Sopa-IA/Control-deck/assets/renders/prototipo/LEEME.md

# Renders del prototipo con las piezas de Miguel (diseño v3)

**Son renders del diseño CAD, no fotos ni un prototipo fabricado.** Generados con
`hardware/render/render_fotorrealista.sh` (Blender + Cycles).

Configuración: `pantalla="msi_15_6"` (MSI PRO MP161 E2U), `hp_preset="iris_mitx_desnuda"` (placa HP 260-a110ns,
17 × 17 cm, 35 mm), `usar_hdd_35=true` (HDD Toshiba 3,5"),
`usar_adaptador_video=false`, Raspberry Pi 4, Arduino Micro, 2 potenciómetros + 2 botones y tira LED ámbar.

**2026-10-20.** Estas imágenes no se han rehecho. Siguen mostrando un Arduino Micro. El CAD vigente es un Nano, con ESP8266, un segundo Nano y un panel en la trasera. La Pi 4, que aquí figuraba sin confirmar, la confirmó Miguel ese día; el HAT VHF no está en estos renders.

| Archivo | Vista |
|---|---|
| 01_frontal_3-4.png | Frontal 3/4 con la interfaz Orbit en la pantalla |
| 02_perfil_lateral.png | Perfil lateral izquierdo |
| 03_trasera_3-4.png | Trasera 3/4: I/O del HP y pasacables |
| 04_explosionado.png | Explosionada |
| 05_interior_cenital.png | Interior desde arriba con etiquetas |
| 06_lo-que-tienes-vs-donde-va.png | Cada pieza y su sitio (versión sin fotos personales) |
| 06_lo-que-tienes-vs-donde-va_con-fotos.png | La misma lámina con recortes de las fotos reales de Miguel (publicación autorizada) |
| 07_detalle_mandos.png | Detalle de la consola y de la textura de capas del PLA+ negro mate |

Exactitud de cada modelo: ver `hardware/render/CREDITOS-MODELOS.md`.
