Sopa-IA/Control-deck/docs/instalacion-hp.md

# Instalar hp-agent en el HP

Un paso por línea. El HP es Windows 10, sin Python. El cable interno une el HP (`<IP-del-HP>`) y la Pi (`<IP-de-la-Pi>`), cada uno con su IP fija. Ese cable no lleva internet: para bajar Python y el agente hace falta el Wi-Fi u otra red.

Por defecto la tarea arranca en vivo: `pythonw.exe -m hp_agent --live`, y el toml queda en `live = true`. Orbit muestra la telemetría, y Bloquear, Reiniciar y Apagar (60 s) se ejecutan ya. `-DryRun` deja solo la telemetría, por si algún día se quiere mirar sin tocar el equipo. Apagar y reiniciar, en vivo, esperan 60 s y se pueden anular.

El token no se escribe en pantalla ni en el registro. ssh pide la contraseña de la Pi y la escribe Miguel.

## Una línea

1. En el HP, abre PowerShell como administrador: clic derecho, Ejecutar como administrador.
2. Pega esta línea y pulsa Enter.

```powershell
[Net.ServicePointManager]::SecurityProtocol = [Net.SecurityProtocolType]::Tls12; $u='https://raw.githubusercontent.com/Sopa-IA/Control-deck/main/scripts/instalar-hp.ps1'; $p=Join-Path $env:TEMP 'instalar-hp.ps1'; Invoke-WebRequest -UseBasicParsing -Uri $u -OutFile $p; powershell -NoProfile -ExecutionPolicy Bypass -File $p
```

3. Cuando ssh pregunte la contraseña, escribe la de la Pi (usuario `orbit`, equipo `<IP-de-la-Pi>`). No se muestra el token.
4. Al terminar, en Orbit OS, Sistemas, la tarjeta del HP tiene que decir **Conectado**. La CPU, la memoria, el disco, el tiempo activo y la red se rellenan. La red va en kb/s, igual que la de la Pi: bajada y subida. La temperatura es la de la CPU si LibreHardwareMonitor está en marcha. Si no hay dato, esa fila sigue en raya y lo demás no se cae.
5. Bloquear, Reiniciar, Anular apagado y Apagar están en la tarjeta del HP y en el menú de apagado. En vivo se ejecutan. Apagar y Reiniciar esperan 60 s y piden confirmación. Anular cancela esos 60 s. Reproducir o pausar está en Herramientas y pulsa la tecla de medios de Windows.

La línea se puede repetir. Sin `-DryRun` deja otra vez el modo real. No cambia el token de la Pi.

## Qué hace

6. Si no hay Python 3.12, lo instala con winget (`Python.Python.3.12`). Si winget no está o no lo deja, baja el instalador oficial `python-3.12.10-amd64.exe` y lo ejecuta en silencio.
7. Baja el zip de la rama `main` a `C:\Orbit\Control-deck`. No hace falta git.
8. Crea `C:\Orbit\Control-deck\.venv` e instala `software/shared/python`, `software/hp-agent`, `pycaw` y `comtypes`. pycaw es el volumen de la salida por defecto. No cambia el token ni la tarea.
9. Por ssh, como `orbit@<IP-de-la-Pi>`, lee `ORBIT_HP_TOKEN` del `.env` de la raíz del clon. En la Pi ese archivo es `/home/orbit/Control-deck/.env`: lo escribe `scripts/gen-token.sh` y `scripts/instalar-pi.sh` no lo regenera si ya existe. `/etc/orbit/orbitd.env` tiene una copia, pero es de root y el usuario `orbit` no la lee.
10. Escribe `%APPDATA%\orbit\hp-agent.toml` con `hub_url = "ws://<IP-de-la-Pi>:8765/ws"` y `live = true`. Con `-DryRun`, `live = false`. El archivo no se enseña.
11. Crea la tarea oculta `OrbitHpAgent`. Arranca al iniciar sesión, con `pythonw.exe -m hp_agent --live`, sin ventana. Con `-DryRun` los argumentos son `-m hp_agent`, sin `--live`. Si el proceso se cae, el Programador de tareas lo relanza al minuto, hasta 999 veces, y no tiene límite de horas. La arranca ya.
12. Baja LibreHardwareMonitor 0.9.6 desde el release oficial de GitHub (`LibreHardwareMonitor.zip`, .NET Framework 4.7.2, licencia MPL-2.0). Comprueba el SHA256 `086d9f1b5a99e643edc2cfaaac16051685b551e4c5ac0b32a57c58c0e529c001` antes de copiarlo a `C:\Orbit\LibreHardwareMonitor`. Si el hash no coincide, no lo instala y el agente sigue. Enciende su servidor web solo en `127.0.0.1:8085`, minimizado a la bandeja, sin ventana. La tarea oculta `OrbitLibreHardwareMonitor` arranca al iniciar sesión con permisos de administrador. hp-agent lee ahí la temperatura de la CPU. Si no hay dato, prueba WMI `root/LibreHardwareMonitor` y, al final, `MSAcpi_ThermalZoneTemperature`.

## Solo mirar

13. La misma línea del paso 2, y al final `-DryRun`:

```powershell
[Net.ServicePointManager]::SecurityProtocol = [Net.SecurityProtocolType]::Tls12; $u='https://raw.githubusercontent.com/Sopa-IA/Control-deck/main/scripts/instalar-hp.ps1'; $p=Join-Path $env:TEMP 'instalar-hp.ps1'; Invoke-WebRequest -UseBasicParsing -Uri $u -OutFile $p; powershell -NoProfile -ExecutionPolicy Bypass -File $p -DryRun
```

14. En vivo, Bloquear llama a `rundll32.exe user32.dll,LockWorkStation`. Apagar es `shutdown /s /t 60`. Reiniciar es `shutdown /r /t 60`. Anular es `shutdown /a`. El volumen y el silencio usan el mezclador de Windows (pycaw), sobre la salida por defecto. Reproducir o pausar pulsa la tecla de medios. La Pi tiene que actualizarse antes que el HP: si no, orbitd rechaza la telemetría nueva.
15. Para volver al modo real, otra vez la línea del paso 2, sin `-DryRun`.

## Comprobar

16. `schtasks /Query /TN OrbitHpAgent /FO LIST /V` muestra la tarea. En los argumentos tiene que aparecer `-m hp_agent --live` (sin `--live` solo si se usó `-DryRun`). Está oculta en la vista simple del Programador.
17. `schtasks /Query /TN OrbitLibreHardwareMonitor /FO LIST /V` muestra la otra tarea. Está oculta y arranca `LibreHardwareMonitor.exe` al iniciar sesión.
18. El registro es `%LOCALAPPDATA%\orbit\hp-agent.log`. No contiene el token. Tiene que aparecer una línea de conectado a `ws://<IP-de-la-Pi>:8765/ws` y `LIVE`. Con `-DryRun`, esa línea dice `DRY-RUN`.
19. En Sistemas, la tarjeta del HP dice Conectado. La fila Red tiene bajada y subida en kb/s. La temperatura muestra grados, o una raya si el monitor aún no ha publicado la CPU. Si dice No conectado, el registro dice si se rechazó la sesión o si no hay cable hasta la Pi (`<IP-de-la-Pi>`).

## Desinstalar

20. En PowerShell como administrador:

```powershell
powershell -NoProfile -ExecutionPolicy Bypass -File C:\Orbit\instalar-hp.ps1 -Desinstalar
```

21. Quita la tarea `OrbitHpAgent`, `C:\Orbit\Control-deck`, la tarea `OrbitLibreHardwareMonitor`, `C:\Orbit\LibreHardwareMonitor` y `%APPDATA%\orbit\hp-agent.toml`. Python 3.12 se queda.
