Sopa-IA/Control-deck/assets/renders/01_msi_frontal_3-4.png

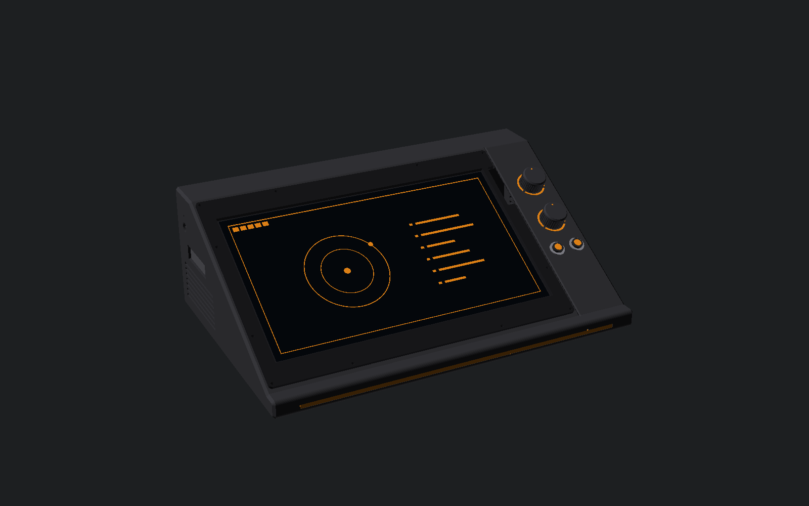
assets/renders/01_msi_frontal_3-4.png
