Sopa-IA/Control-deck/assets/renders/01b_msi_frontal_der_3-4.png

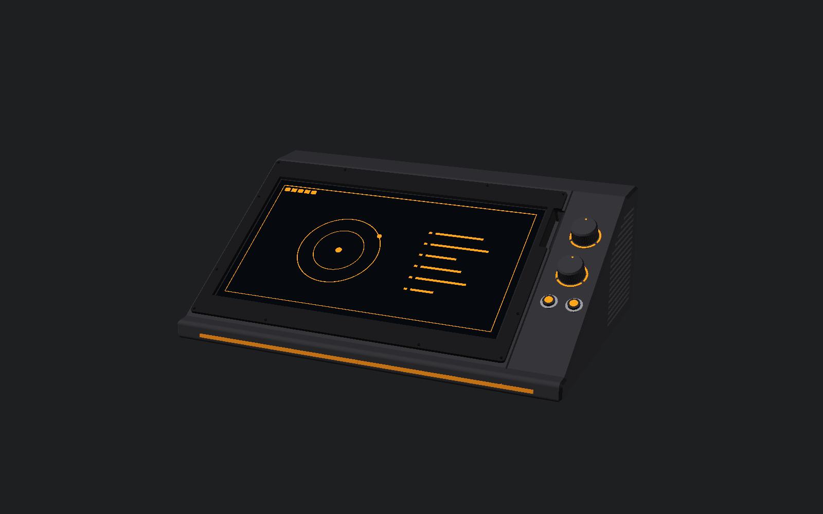
assets/renders/01b_msi_frontal_der_3-4.png
