Sopa-IA/Control-deck/assets/renders/02_msi_lateral.png

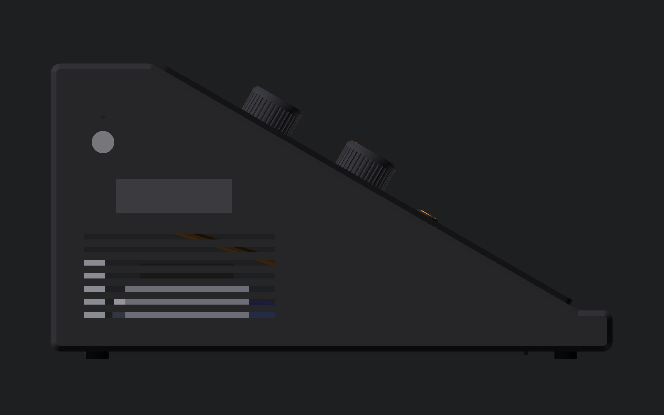
assets/renders/02_msi_lateral.png
