Sopa-IA/Control-deck/assets/renders/03_msi_trasera_3-4.png

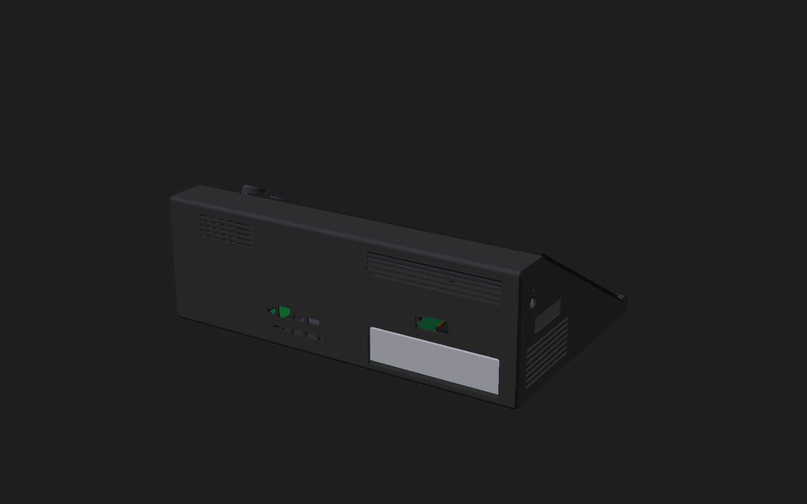
assets/renders/03_msi_trasera_3-4.png
