Sopa-IA/Control-deck/assets/renders/04_msi_explosionado.png

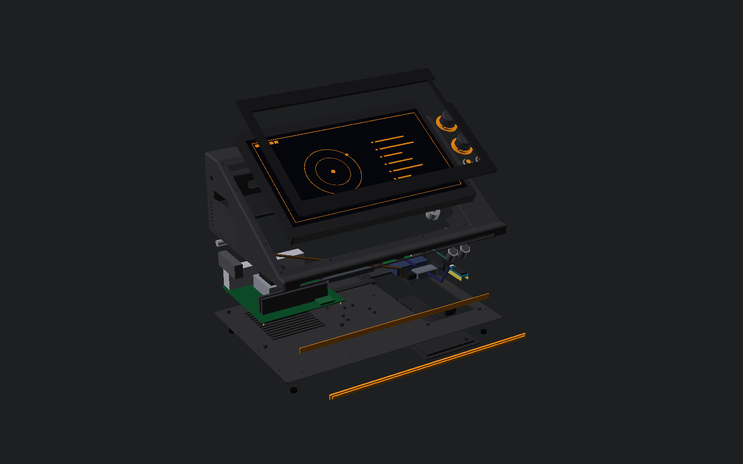
assets/renders/04_msi_explosionado.png
