Sopa-IA/Control-deck/assets/renders/05_msi_interior.png

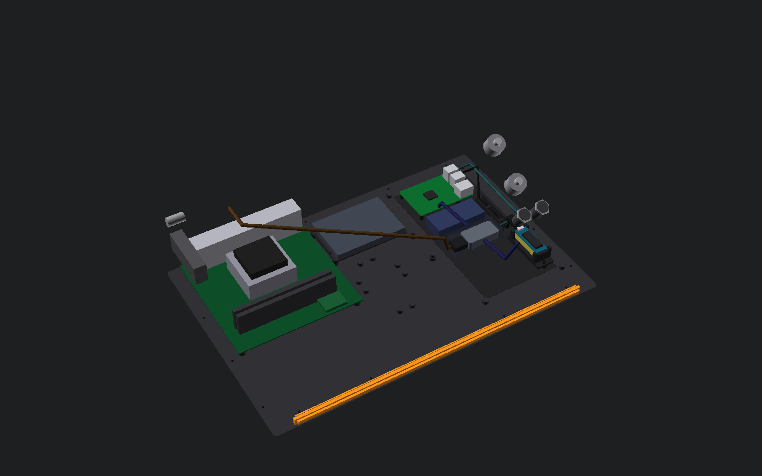
assets/renders/05_msi_interior.png
