Sopa-IA/Control-deck/assets/renders/05b_msi_interior_mandos.png

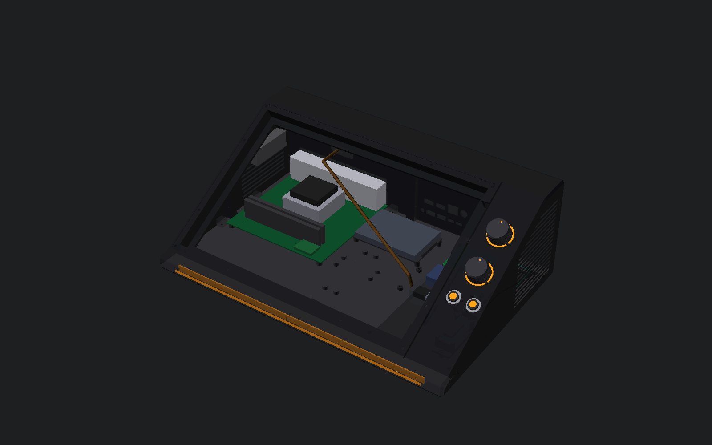
assets/renders/05b_msi_interior_mandos.png
