Sopa-IA/Control-deck/assets/renders/07_msi_detalle_consola.png

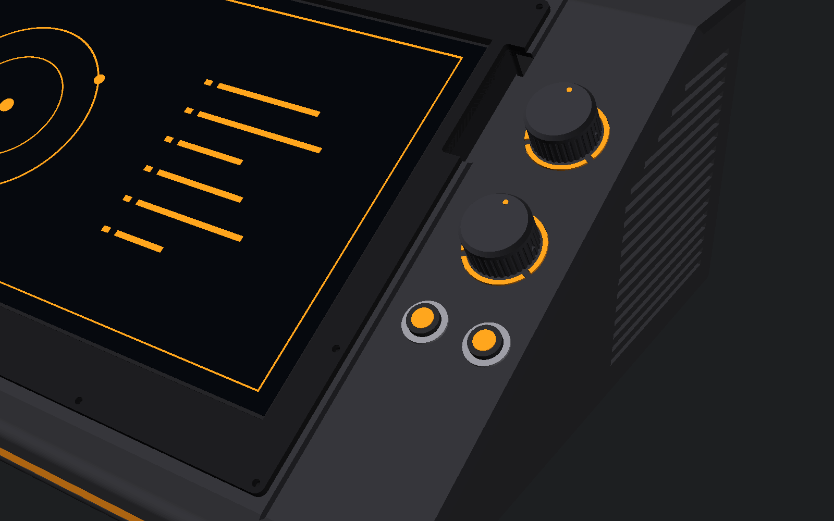
assets/renders/07_msi_detalle_consola.png
