Sopa-IA/Control-deck/assets/renders/prototipo/01_frontal_3-4.png

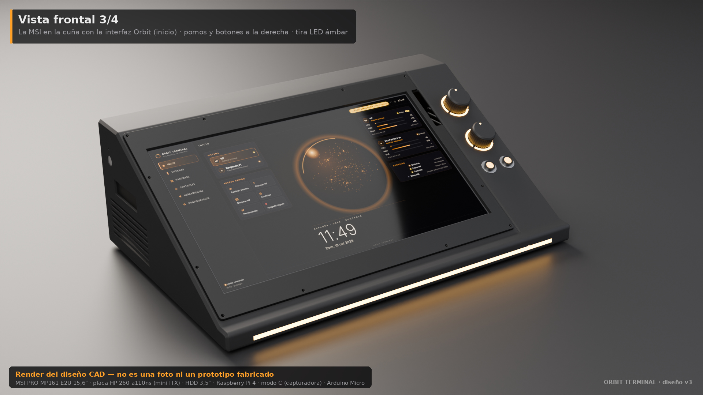
assets/renders/prototipo/01_frontal_3-4.png
