Sopa-IA/Control-deck/assets/renders/prototipo/02_perfil_lateral.png

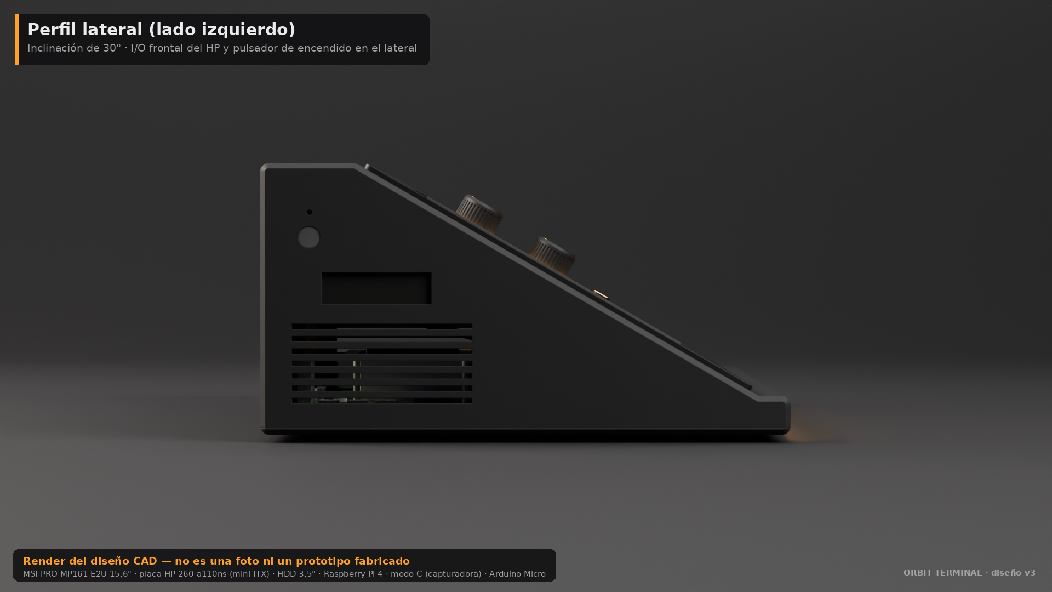
assets/renders/prototipo/02_perfil_lateral.png
