Sopa-IA/Control-deck/assets/renders/prototipo/03_trasera_3-4.png

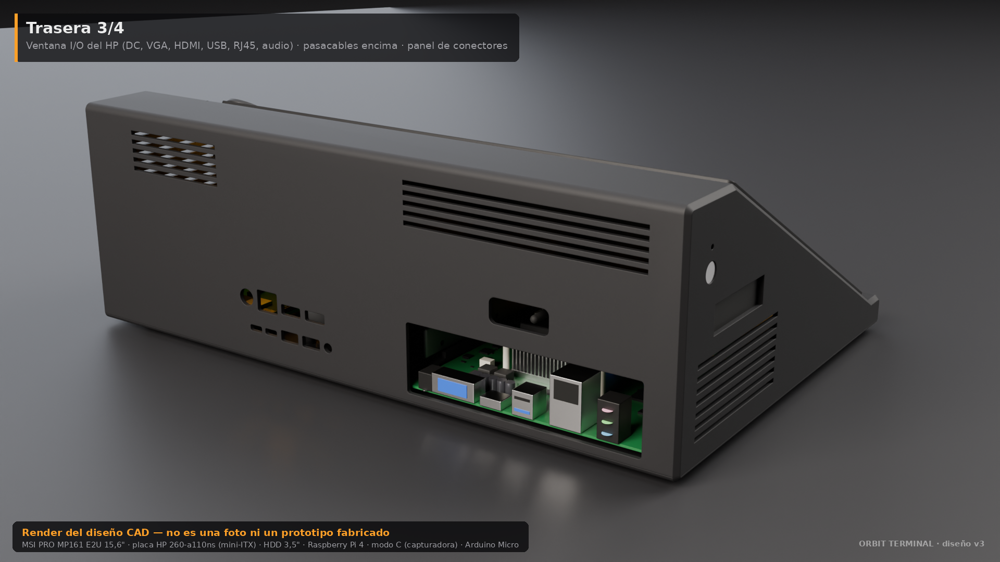
assets/renders/prototipo/03_trasera_3-4.png
