Sopa-IA/Control-deck/assets/renders/prototipo/04_explosionado.png

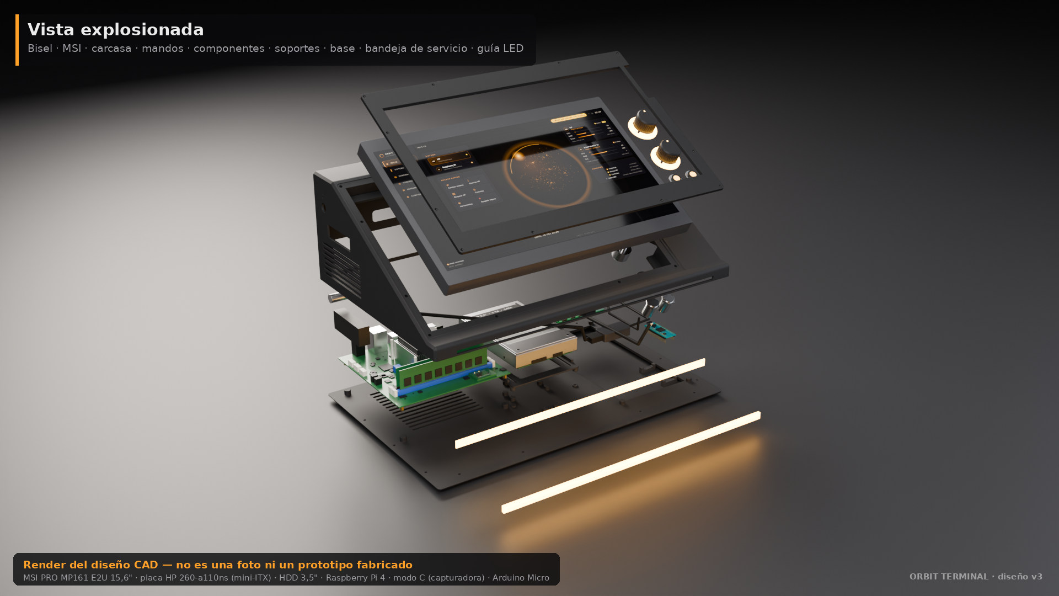
assets/renders/prototipo/04_explosionado.png
