Sopa-IA/Control-deck/assets/renders/prototipo/05_interior_cenital.png

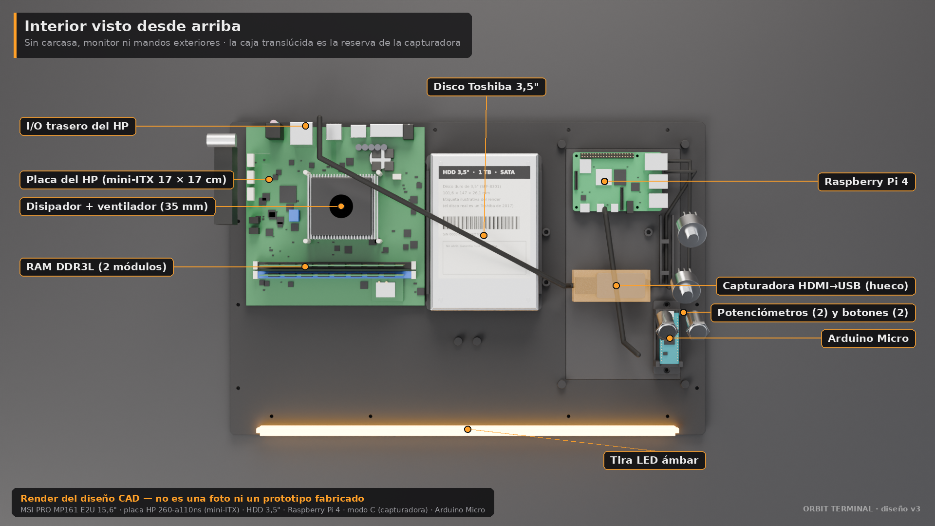
assets/renders/prototipo/05_interior_cenital.png
