Sopa-IA/Control-deck/assets/renders/prototipo/06_lo-que-tienes-vs-donde-va_con-fotos.png

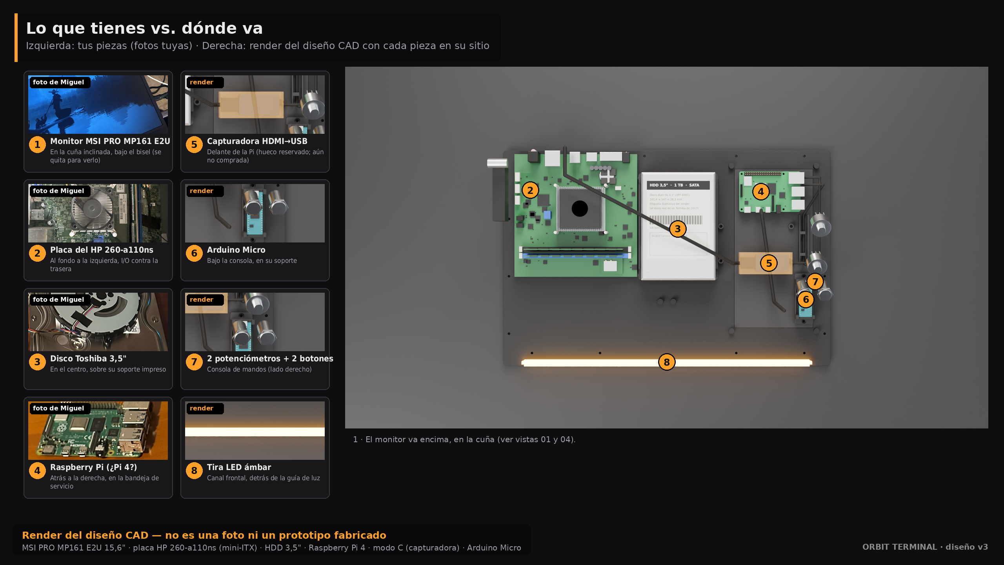
assets/renders/prototipo/06_lo-que-tienes-vs-donde-va_con-fotos.png
