Sopa-IA/Control-deck/assets/renders/prototipo/07_detalle_mandos.png

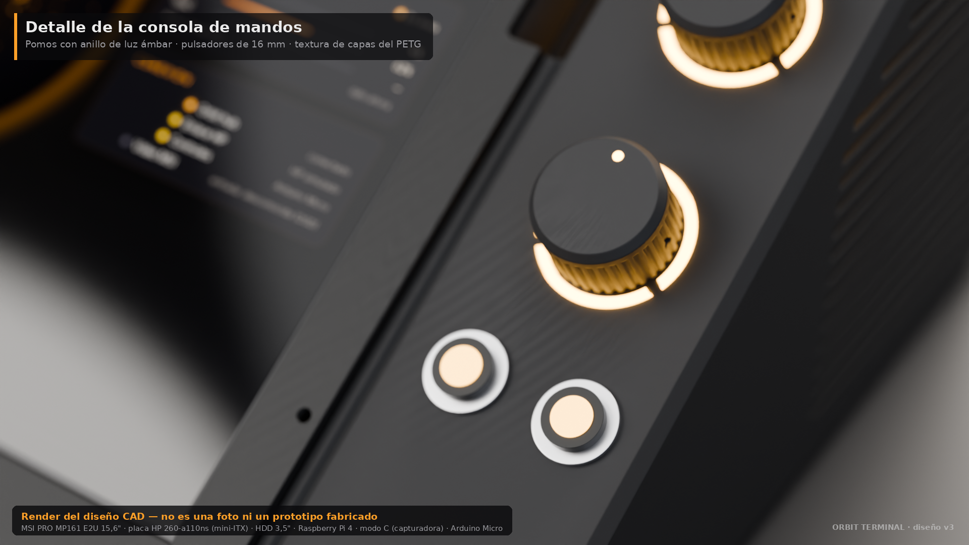
assets/renders/prototipo/07_detalle_mandos.png
