Sopa-IA/Control-deck/assets/screenshots/ardulab_1920x1080.png

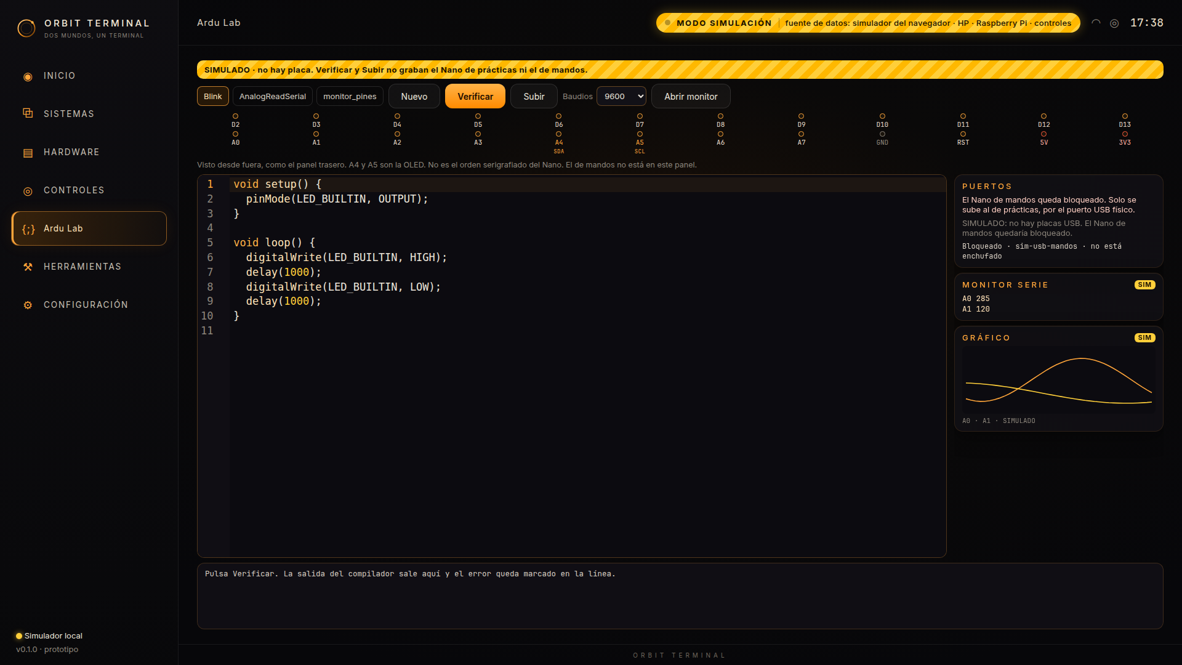
assets/screenshots/ardulab_1920x1080.png
