Sopa-IA/Control-deck/assets/screenshots/controles_1920x1080.png

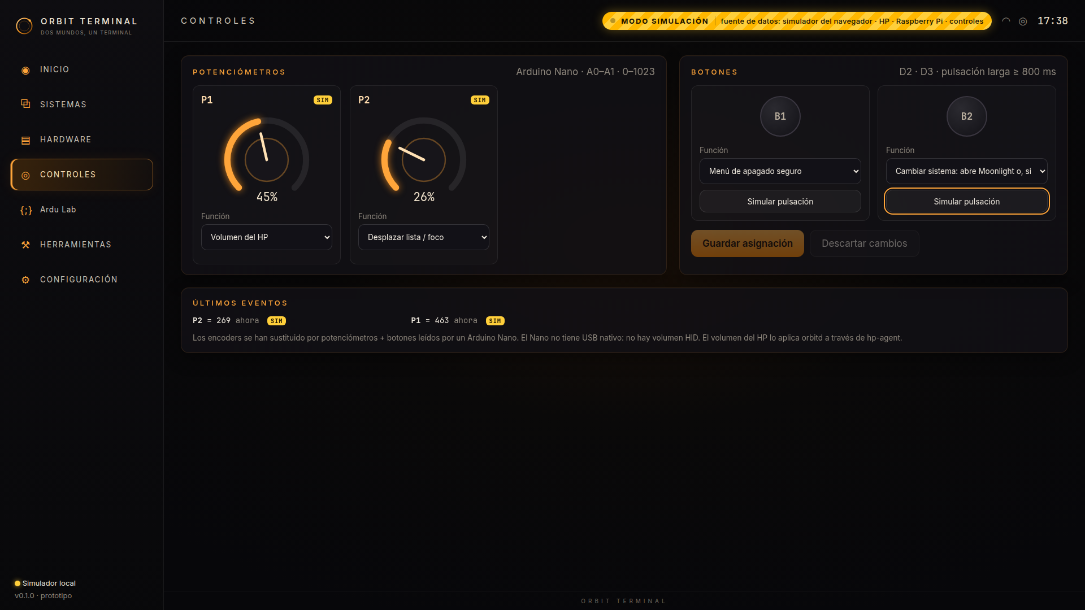
assets/screenshots/controles_1920x1080.png
