Sopa-IA/Control-deck/assets/screenshots/hardware_1920x1080.png

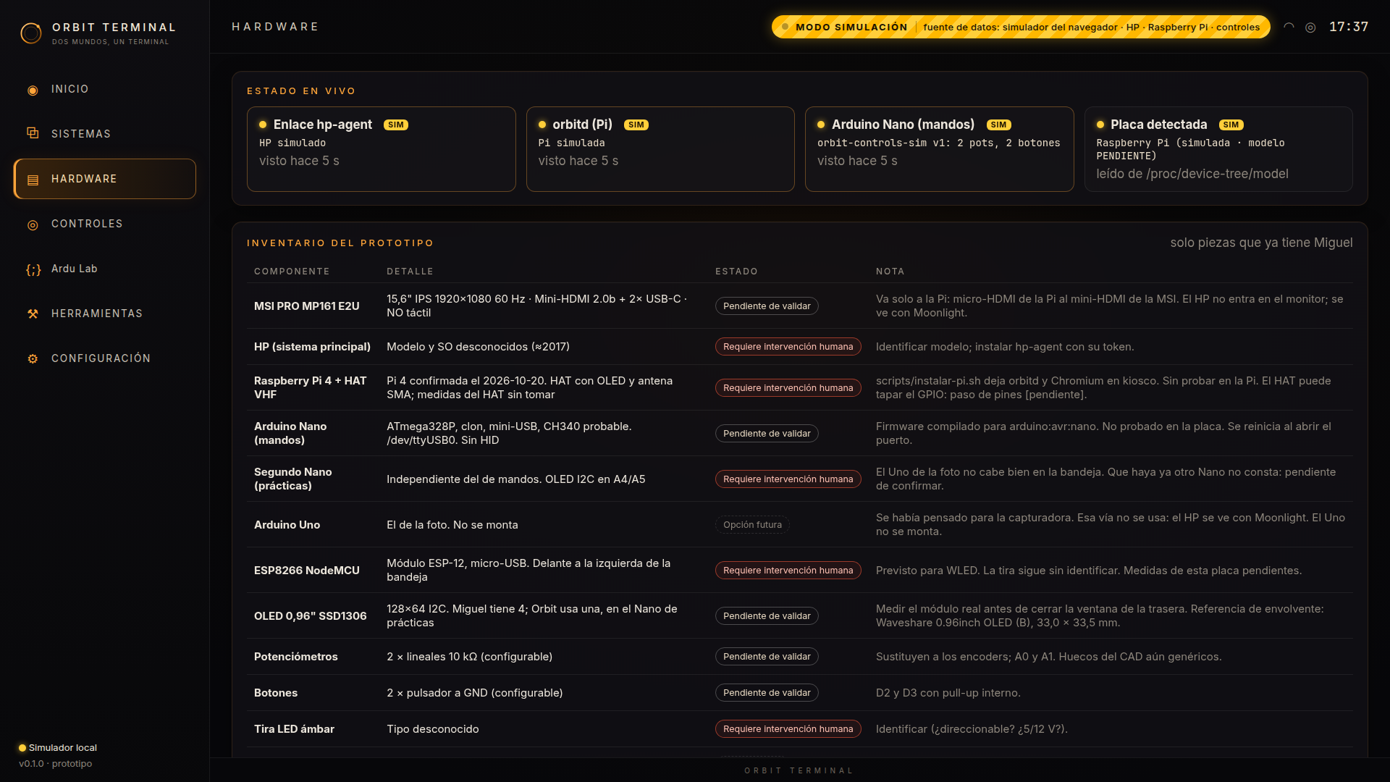
assets/screenshots/hardware_1920x1080.png
