Sopa-IA/Control-deck/assets/screenshots/inicio_1920x720.png

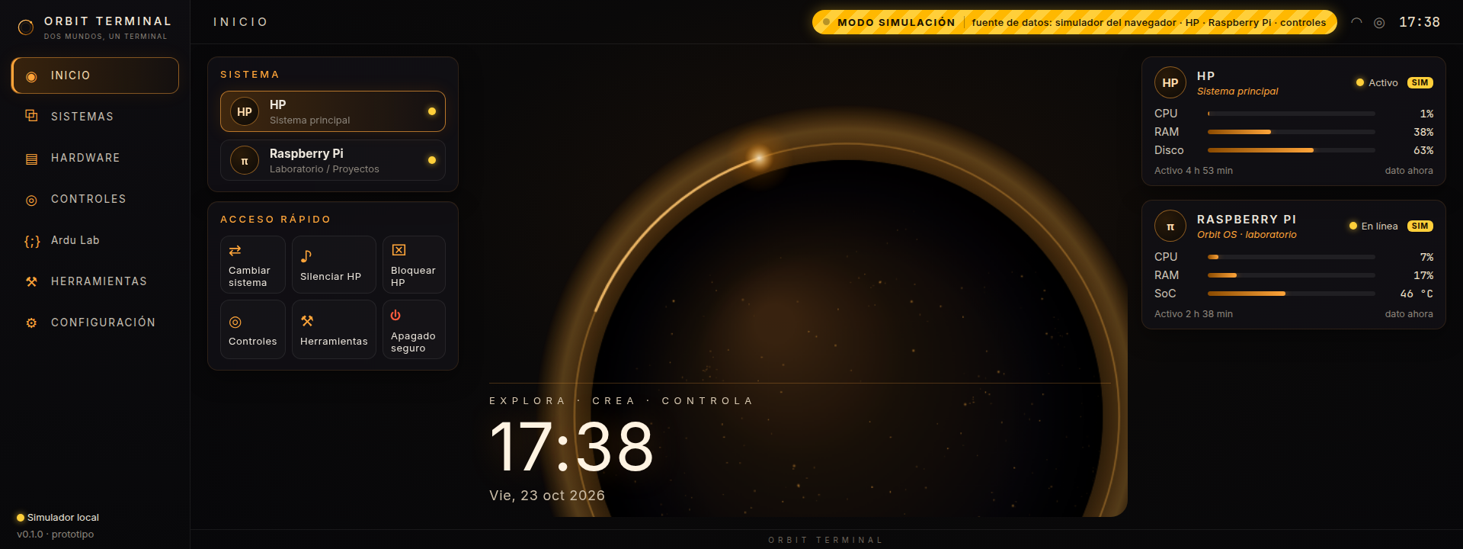
assets/screenshots/inicio_1920x720.png
