Sopa-IA/Control-deck/assets/screenshots/integrado_1920x1080.png

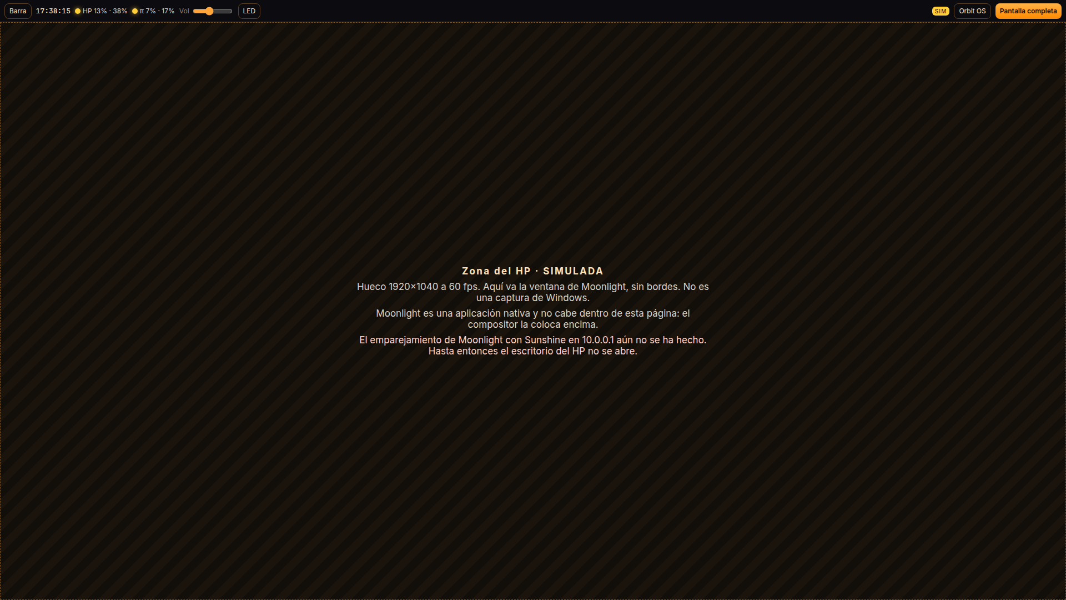
assets/screenshots/integrado_1920x1080.png
