Sopa-IA/Control-deck/assets/screenshots/sistemas_1920x1080.png

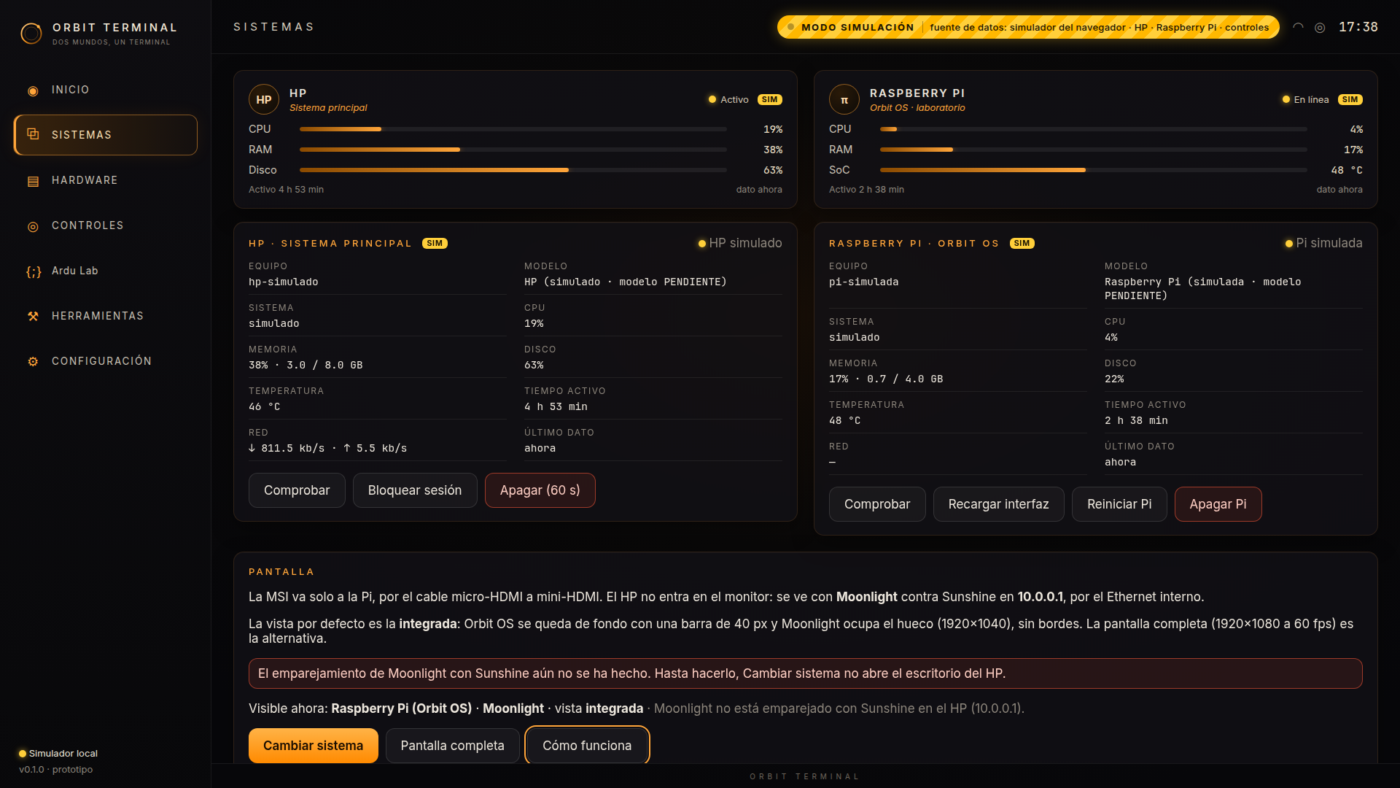
assets/screenshots/sistemas_1920x1080.png
