Sopa-IA/Control-deck/hardware/impresion/base/vista_base.png

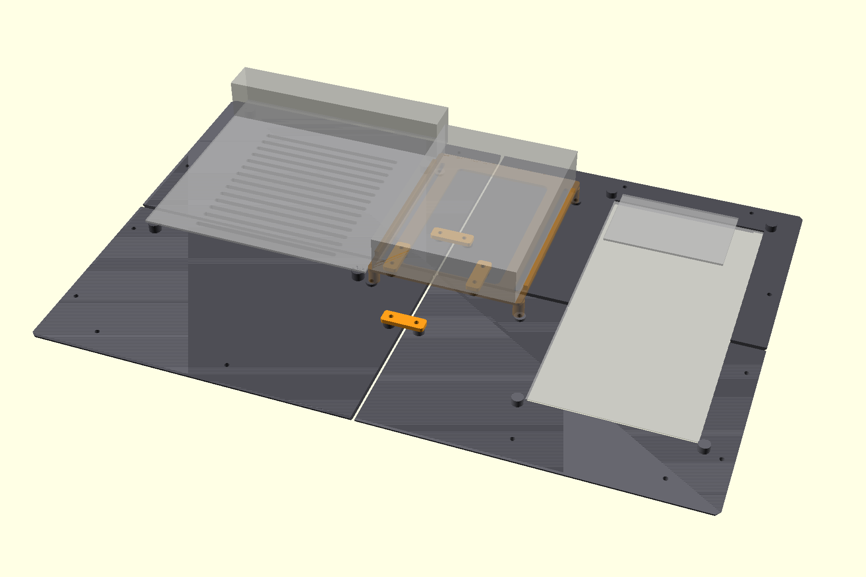
hardware/impresion/base/vista_base.png
