Sopa-IA/Control-deck/hardware/impresion/base/vista_base_planta.png

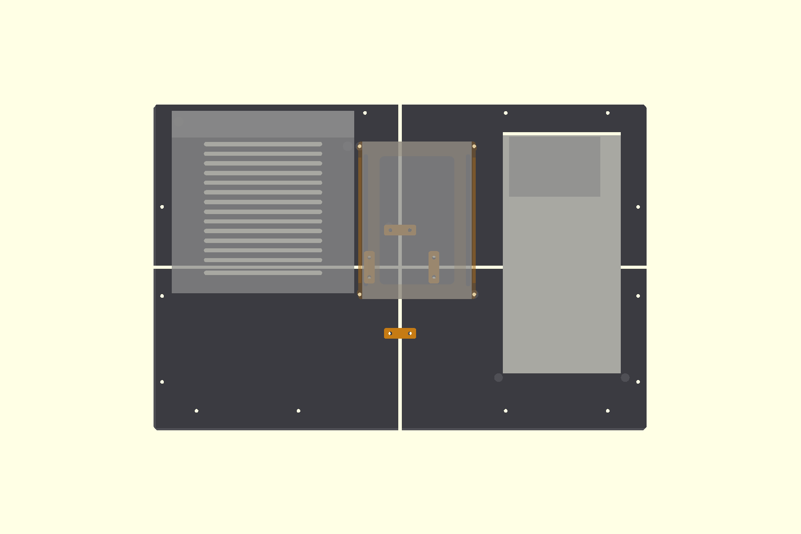
hardware/impresion/base/vista_base_planta.png
