Sopa-IA/Control-deck/hardware/impresion/plantillas/vista_pivotes.png

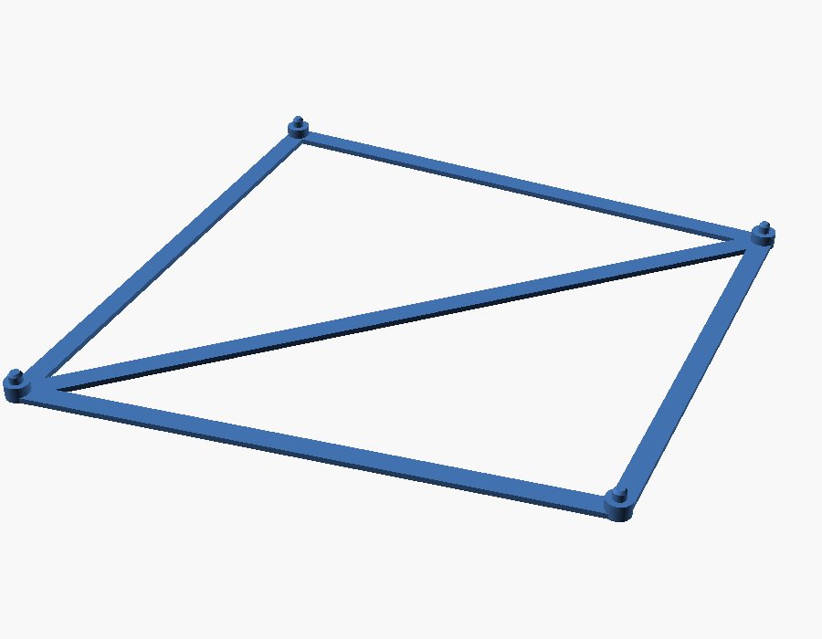
hardware/impresion/plantillas/vista_pivotes.png
