Sopa-IA/Control-deck/hardware/impresion/siguientes/vista_siguientes_conjunto.png

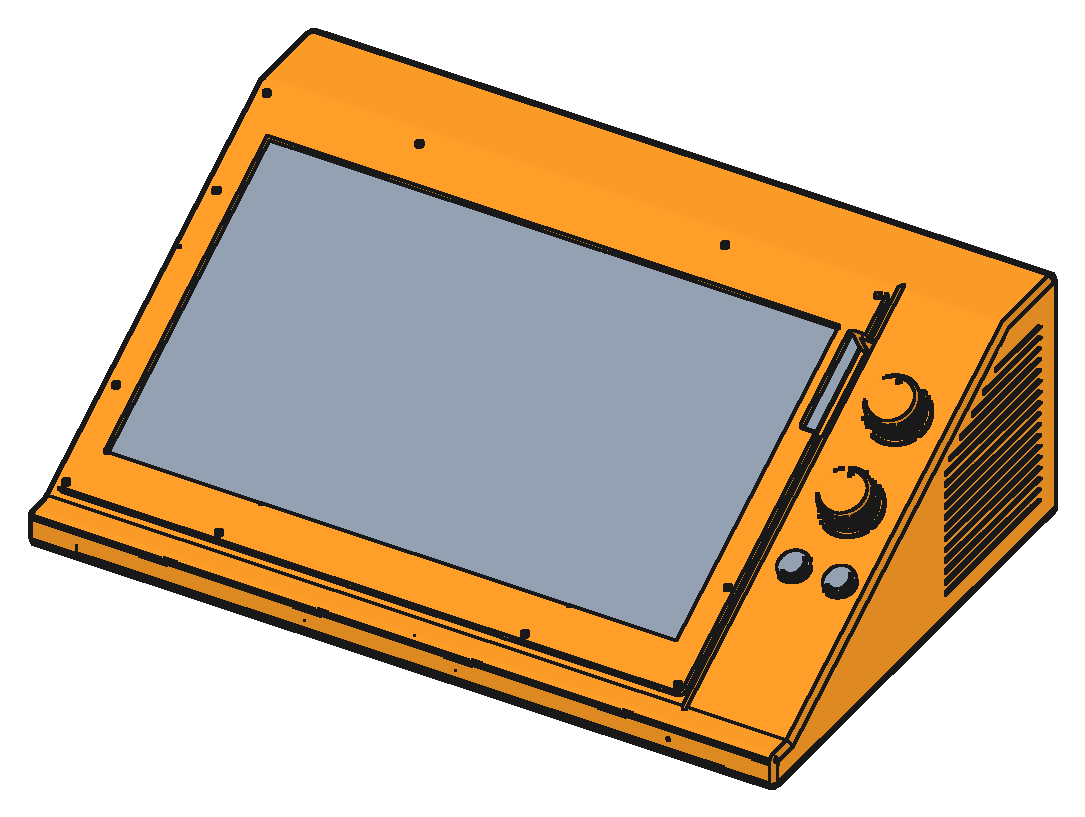
hardware/impresion/siguientes/vista_siguientes_conjunto.png
