Sopa-IA/Control-deck/hardware/cad/export/stl/PROVISIONAL_tapa_pi.stl

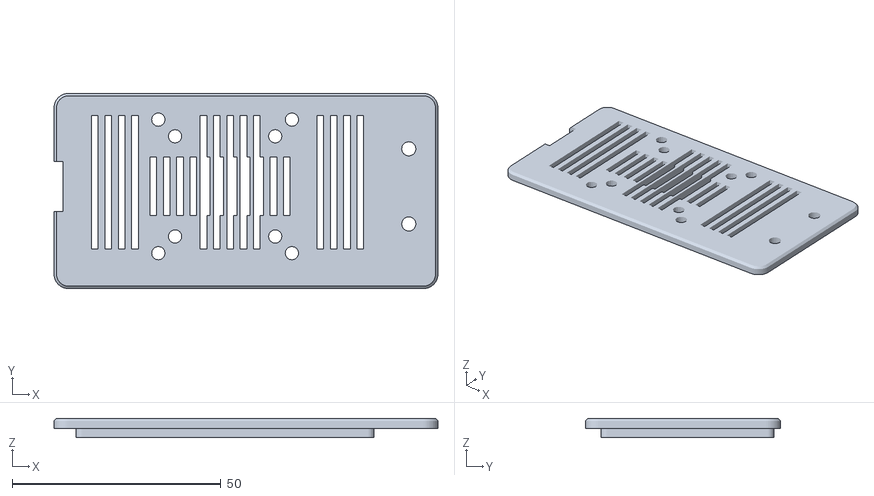
[picture p28: CAD file, 2026-10-24]
hardware/cad/export/stl/PROVISIONAL_tapa_pi.stl
92.0 x 46.8 x 4.60
