Sopa-IA/Control-deck/hardware/impresion/base/STEP/PROVISIONAL_base_x0_y1.step

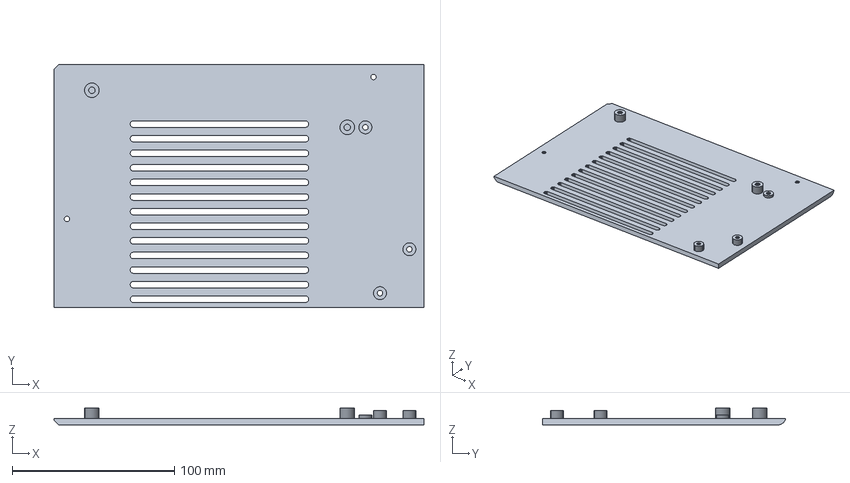
[picture p29: CAD file, 2026-10-20]
hardware/impresion/base/STEP/PROVISIONAL_base_x0_y1.step
228.1 x 150.1 x 10.4 mm
