Sopa-IA/Control-deck/hardware/impresion/plantillas/PRUEBA_plantilla_pivotes_HP.stl

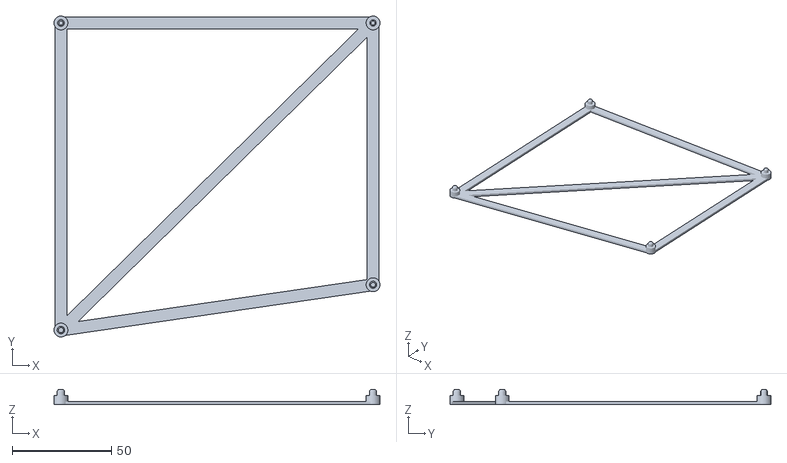
[picture p30: CAD file, 2026-10-20]
hardware/impresion/plantillas/PRUEBA_plantilla_pivotes_HP.stl
164.5 x 161.9 x 7.60
