Sopa-IA/Control-deck/hardware/impresion/siguientes/STEP/10_PROVISIONAL_bisel_x1_y1.step

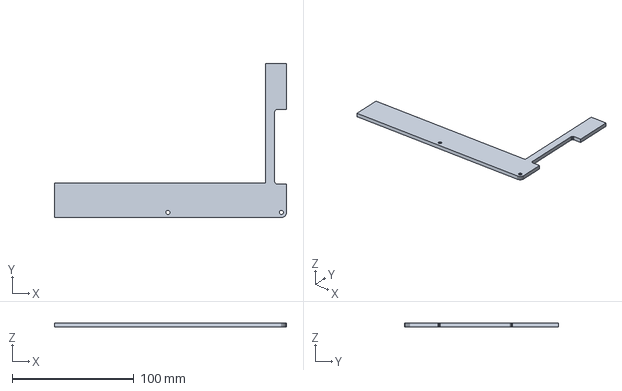
[picture p31: CAD file, 2026-10-20]
hardware/impresion/siguientes/STEP/10_PROVISIONAL_bisel_x1_y1.step
190.8 x 126.6 x 3.60 mm
