Sopa-IA/Control-deck/hardware/cad/export/stl/OBSOLETA_bandeja_huecos_v2_ya_impresa.stl

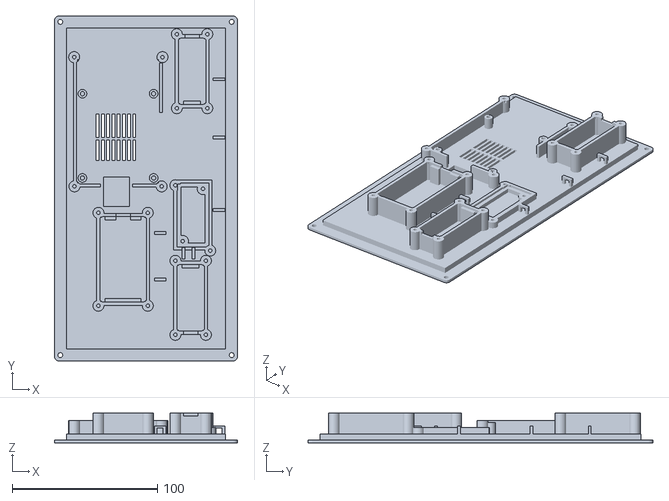
[picture p32: CAD file, 2026-10-24]
hardware/cad/export/stl/OBSOLETA_bandeja_huecos_v2_ya_impresa.stl
126.0 x 237.5 x 20.6
