Sopa-IA/Control-deck/hardware/impresion/base/STEP/PROVISIONAL_soporte_disco.step

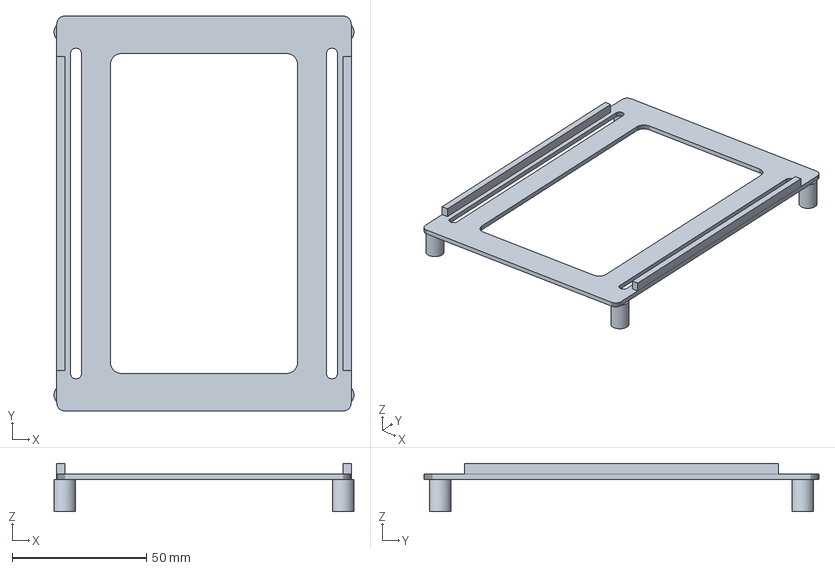
[picture p33: CAD file, 2026-10-20]
hardware/impresion/base/STEP/PROVISIONAL_soporte_disco.step
111.6 x 147.0 x 18.0 mm
