Sopa-IA/Control-deck/hardware/impresion/plantillas/PRUEBA_plantilla_agujeros_HP.stl

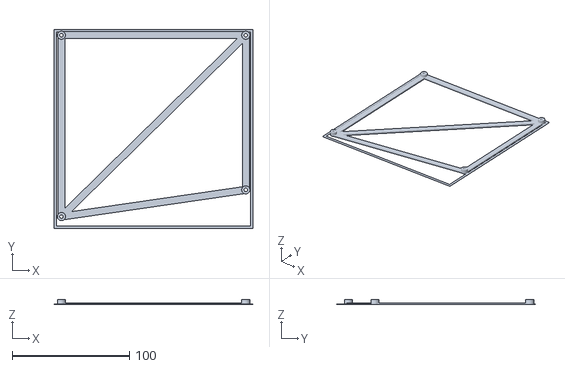
[picture p34: CAD file, 2026-10-20]
hardware/impresion/plantillas/PRUEBA_plantilla_agujeros_HP.stl
170.0 x 170.0 x 4.60
