Sopa-IA/Control-deck/hardware/impresion/siguientes/STEP/13_PROVISIONAL_anillo_luz_x2.step

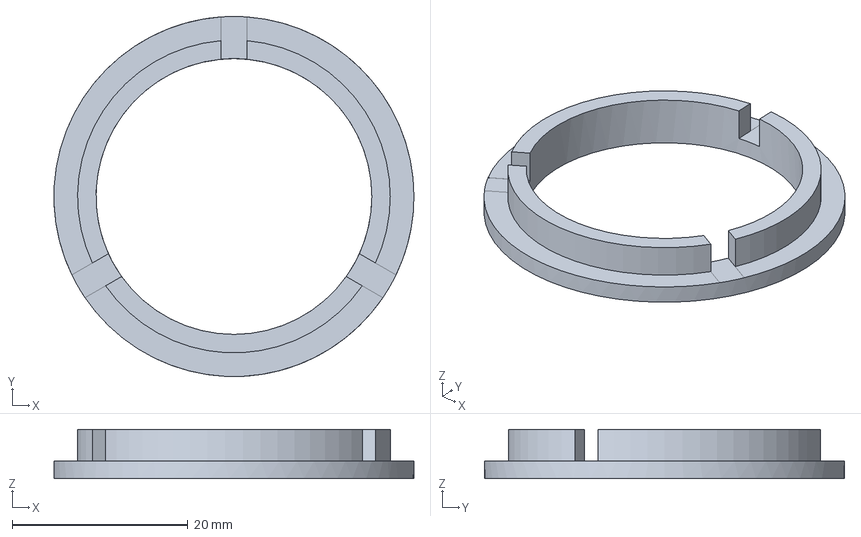
[picture p35: CAD file, 2026-10-20]
hardware/impresion/siguientes/STEP/13_PROVISIONAL_anillo_luz_x2.step
41.0 x 41.0 x 5.60 mm
