Sopa-IA/Control-deck/hardware/impresion/siguientes/STEP/12_PROVISIONAL_guia_luz_frontal_1.step

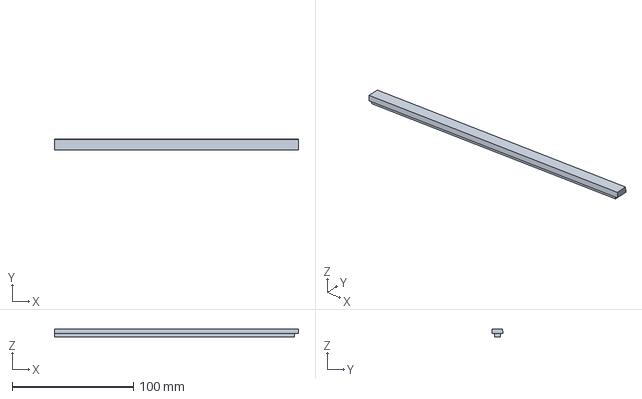
[picture p37: CAD file, 2026-10-20]
hardware/impresion/siguientes/STEP/12_PROVISIONAL_guia_luz_frontal_1.step
201.1 x 9.00 x 6.95 mm
