Sopa-IA/Control-deck/hardware/cad/export/stl/FUTURO_carcasa_x0_y1_sin_adaptadores.stl

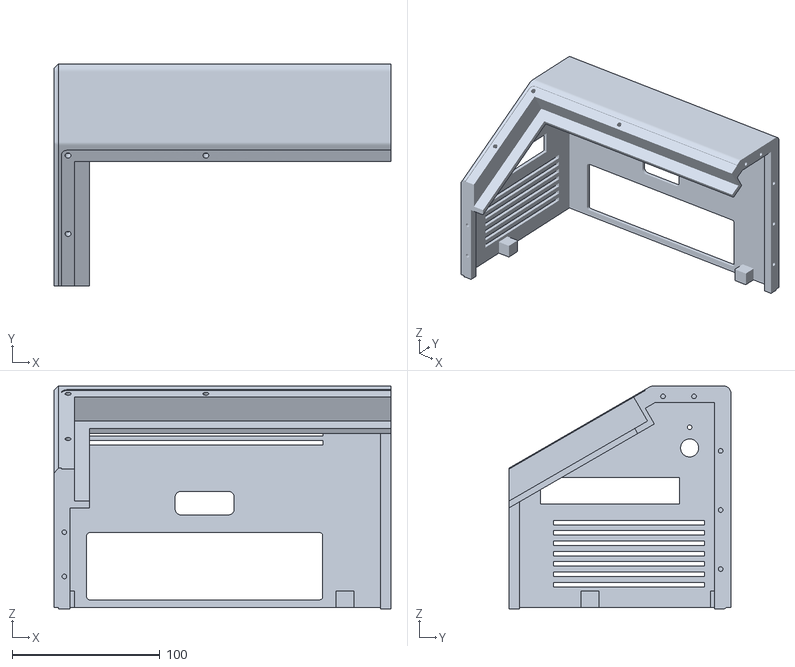
[picture p38: CAD file, 2026-10-24]
hardware/cad/export/stl/FUTURO_carcasa_x0_y1_sin_adaptadores.stl
228.1 x 150.2 x 150.9
