Sopa-IA/Control-deck/hardware/impresion/base/STEP/PROVISIONAL_base_x1_y0.step

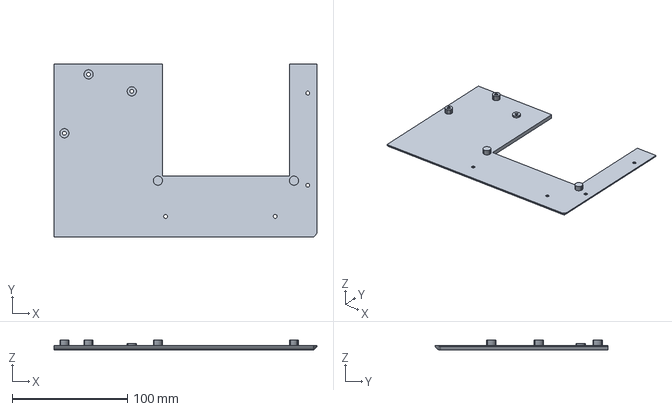
[picture p39: CAD file, 2026-10-20]
hardware/impresion/base/STEP/PROVISIONAL_base_x1_y0.step
228.1 x 150.1 x 8.99 mm
