Sopa-IA/Control-deck/hardware/impresion/siguientes/STEP/02_PROVISIONAL_bandeja_servicio.step

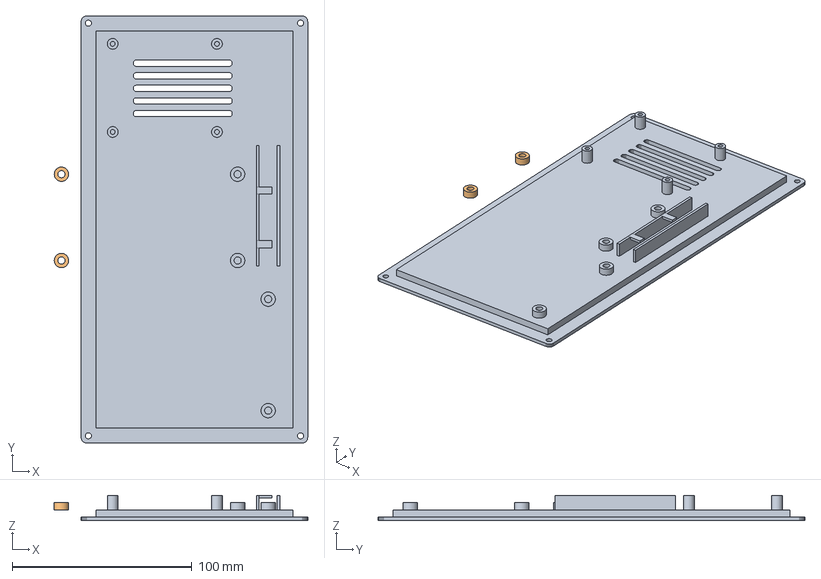
[picture p40: CAD file, 2026-10-20]
hardware/impresion/siguientes/STEP/02_PROVISIONAL_bandeja_servicio.step
141.0 x 237.5 x 14.0 mm
