Sopa-IA/Control-deck/hardware/cad/export/stl/PROVISIONAL_grapa_esquina.stl

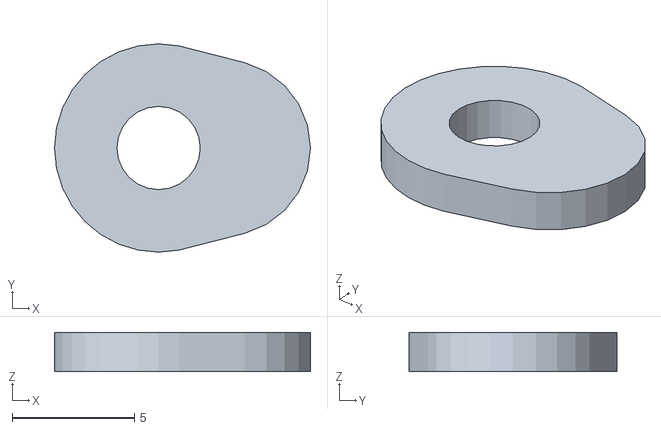
[picture p41: CAD file, 2026-10-24]
hardware/cad/export/stl/PROVISIONAL_grapa_esquina.stl
10.4 x 8.50 x 1.60
