Sopa-IA/Control-deck/hardware/cad/export/stl/PRUEBA_boton.stl

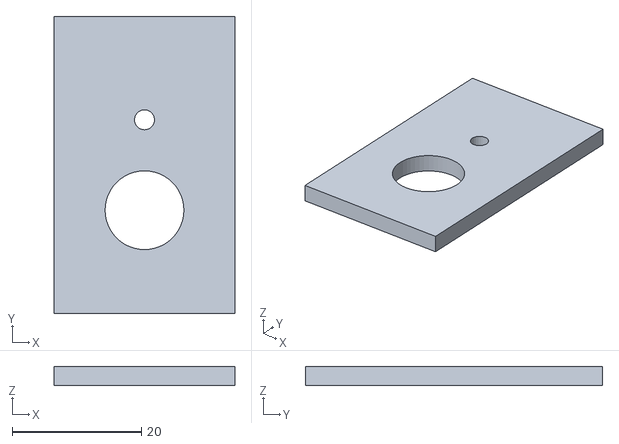
[picture p42: CAD file, 2026-10-24]
hardware/cad/export/stl/PRUEBA_boton.stl
28.0 x 46.0 x 3.00
