Sopa-IA/Control-deck/hardware/cad/export/stl/PROVISIONAL_carro_esp.stl

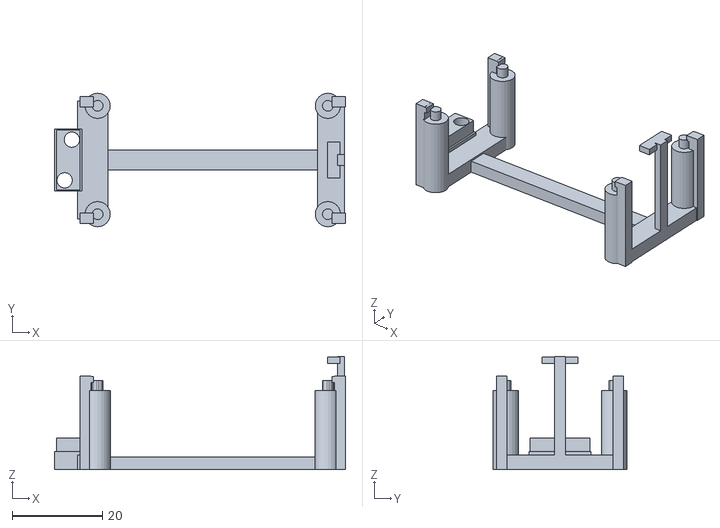
[picture p44: CAD file, 2026-10-24]
hardware/cad/export/stl/PROVISIONAL_carro_esp.stl
64.5 x 29.6 x 25.1
