Sopa-IA/Control-deck/hardware/impresion/base/STEP/PRUEBA_pared_trasera_IO_HP.step

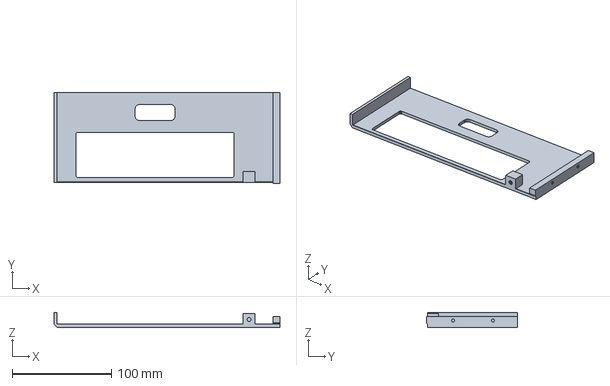
[picture p45: CAD file, 2026-10-20]
hardware/impresion/base/STEP/PRUEBA_pared_trasera_IO_HP.step
228.1 x 92.0 x 15.0 mm
