Sopa-IA/Control-deck/hardware/impresion/siguientes/STEP/14_PROVISIONAL_pomo_x2.step

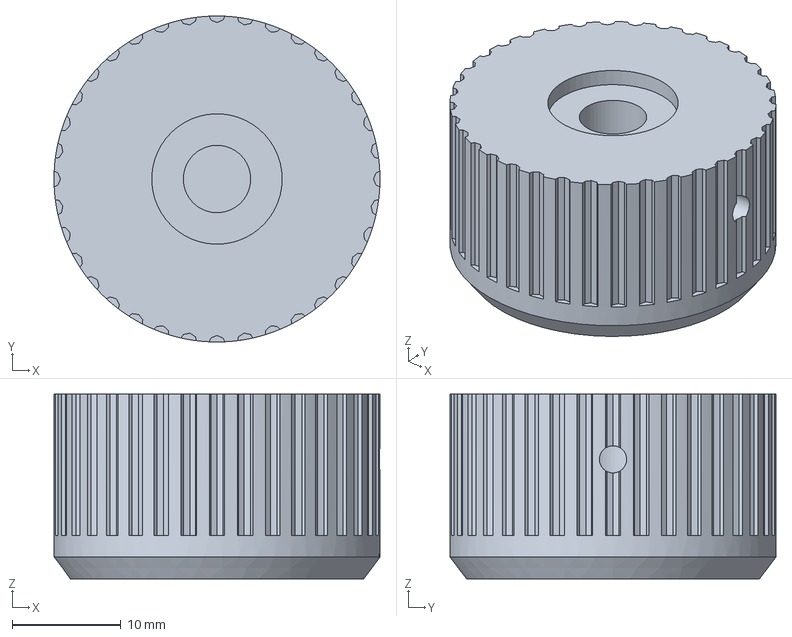
[picture p46: CAD file, 2026-10-20]
hardware/impresion/siguientes/STEP/14_PROVISIONAL_pomo_x2.step
30.0 x 30.0 x 17.0 mm
