Sopa-IA/Control-deck/hardware/cad/export/stl/PROVISIONAL_soporte_boton.stl

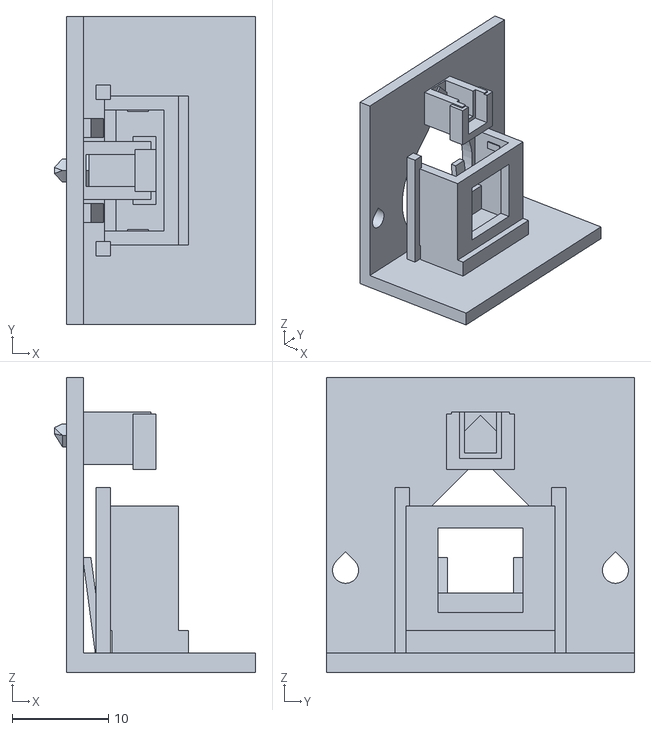
[picture p47: CAD file, 2026-10-24]
hardware/cad/export/stl/PROVISIONAL_soporte_boton.stl
20.9 x 32.0 x 30.6
