Sopa-IA/Control-deck/hardware/impresion/base/STEP/PROVISIONAL_pletina_empalme_x4.step

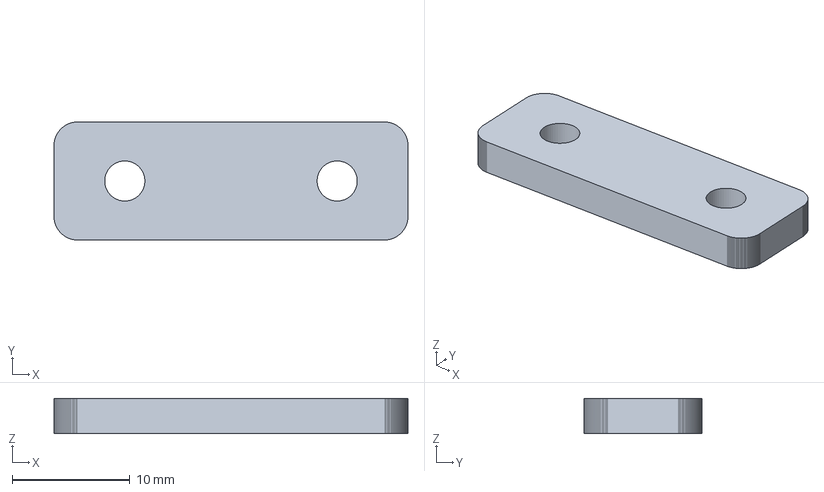
[picture p48: CAD file, 2026-10-20]
hardware/impresion/base/STEP/PROVISIONAL_pletina_empalme_x4.step
30.0 x 10.00 x 3.00 mm
