Sopa-IA/Control-deck/hardware/impresion/siguientes/STEP/09_PROVISIONAL_bisel_x1_y0.step

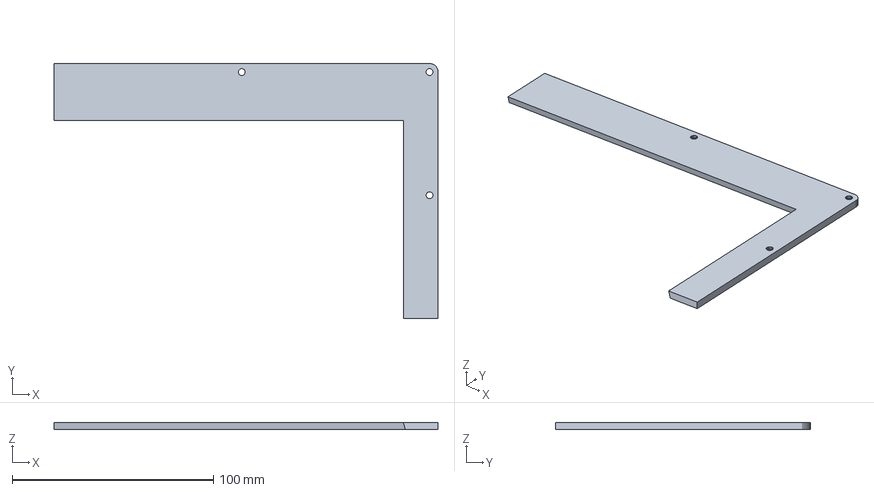
[picture p49: CAD file, 2026-10-20]
hardware/impresion/siguientes/STEP/09_PROVISIONAL_bisel_x1_y0.step
190.8 x 126.6 x 3.60 mm
