Sopa-IA/Control-deck/hardware/cad/export/stl/PROVISIONAL_carro_proto30x70.stl

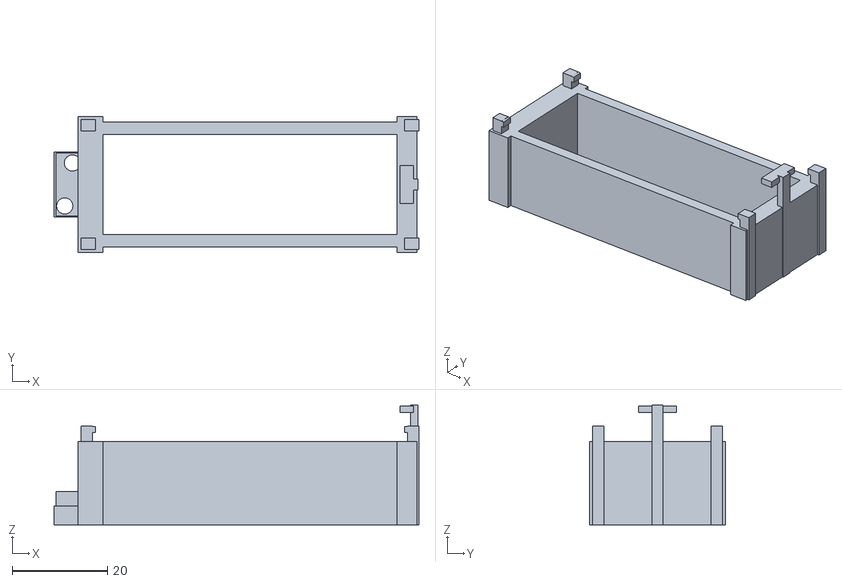
[picture p50: CAD file, 2026-10-24]
hardware/cad/export/stl/PROVISIONAL_carro_proto30x70.stl
76.5 x 28.4 x 25.1
