Sopa-IA/Control-deck/hardware/impresion/siguientes/STEP/05_PROVISIONAL_carcasa_x1_y0.step

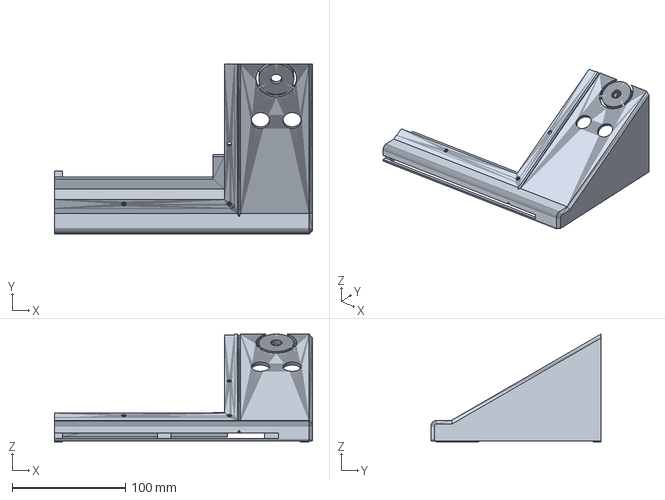
[picture p51: CAD file, 2026-10-20]
hardware/impresion/siguientes/STEP/05_PROVISIONAL_carcasa_x1_y0.step
228.1 x 150.2 x 95.4 mm
