Sopa-IA/Control-deck/hardware/cad/export/stl/PROVISIONAL_bandeja_servicio.stl

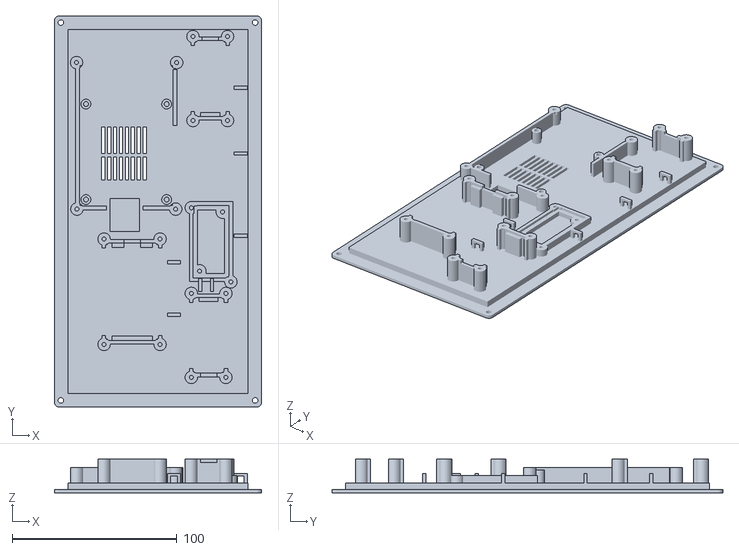
[picture p52: CAD file, 2026-10-24]
hardware/cad/export/stl/PROVISIONAL_bandeja_servicio.stl
126.0 x 237.5 x 20.6
