Sopa-IA/Control-deck/hardware/impresion/siguientes/STEP/15_PROVISIONAL_soporte_arduino.step

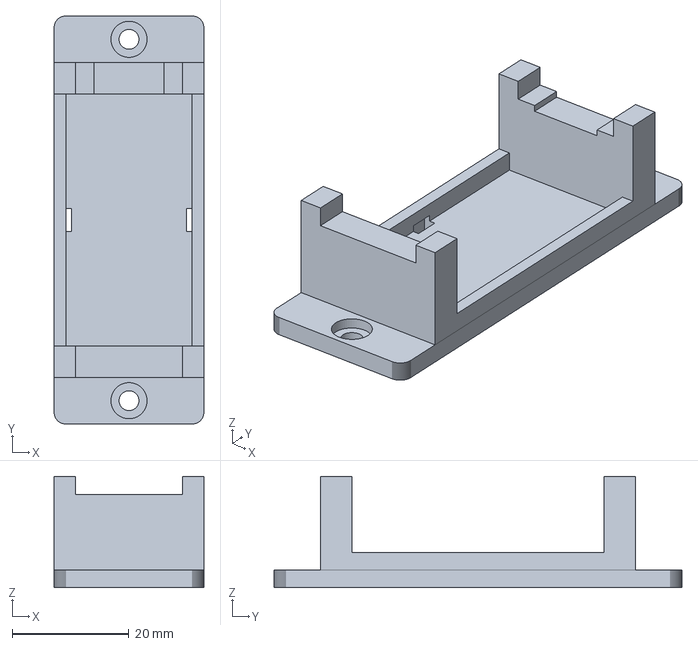
[picture p53: CAD file, 2026-10-20]
hardware/impresion/siguientes/STEP/15_PROVISIONAL_soporte_arduino.step
25.7 x 70.0 x 19.1 mm
