Sopa-IA/Control-deck/hardware/cad/export/stl/PRUEBA_placa_io_hp.stl

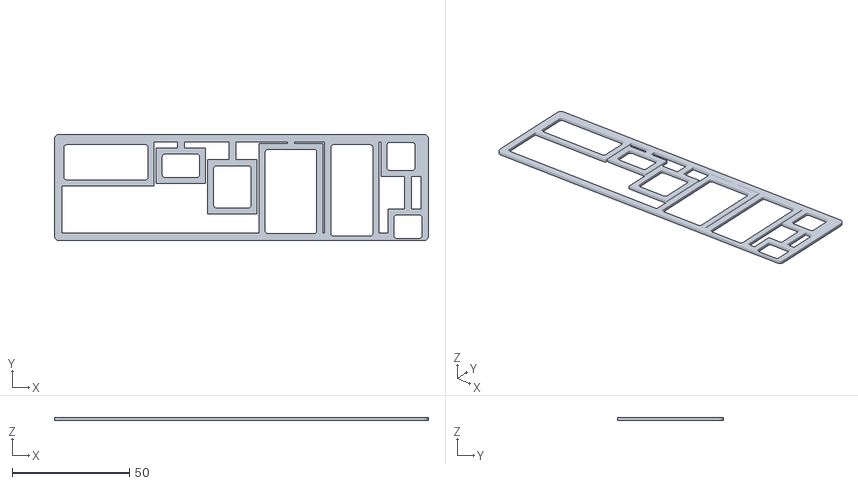
[picture p54: CAD file, 2026-10-24]
hardware/cad/export/stl/PRUEBA_placa_io_hp.stl
159.8 x 45.5 x 1.40
