Sopa-IA/Control-deck/hardware/cad/export/stl/PROVISIONAL_placa_io_hp.stl

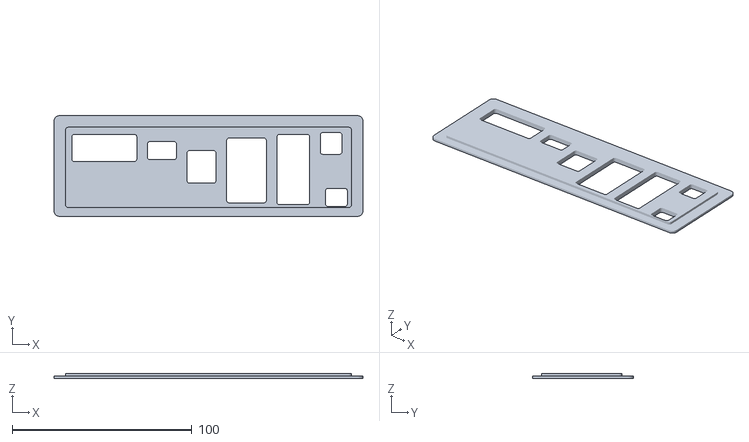
[picture p55: CAD file, 2026-10-24]
hardware/cad/export/stl/PROVISIONAL_placa_io_hp.stl
171.8 x 56.0 x 2.80
