Sopa-IA/Control-deck/hardware/cad/export/stl/PROVISIONAL_retenedor_nano.stl

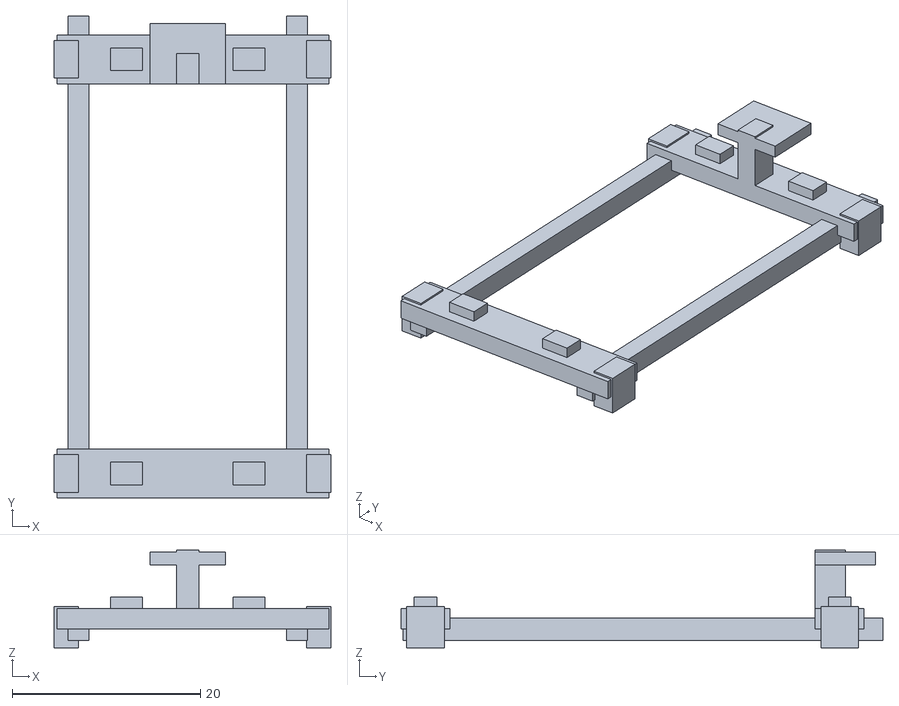
[picture p56: CAD file, 2026-10-24]
hardware/cad/export/stl/PROVISIONAL_retenedor_nano.stl
29.4 x 51.2 x 10.4
