Sopa-IA/Control-deck/hardware/cad/export/stl/PROVISIONAL_marco_io_frontal.stl

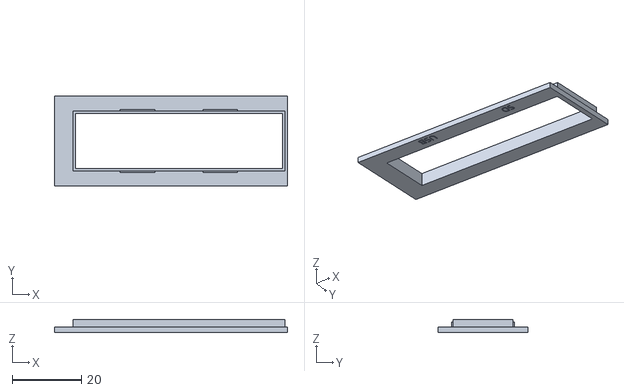
[picture p58: CAD file, 2026-10-24]
hardware/cad/export/stl/PROVISIONAL_marco_io_frontal.stl
67.4 x 26.0 x 3.80
