Sopa-IA/Control-deck/hardware/cad/export/stl/PROVISIONAL_carro_nano.stl

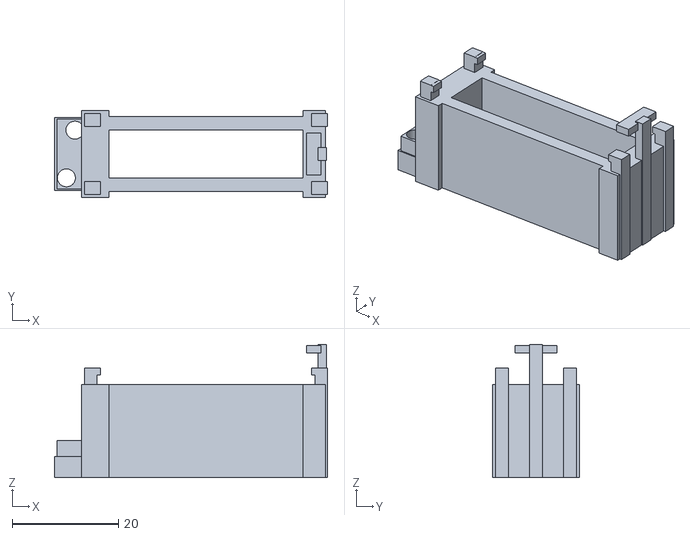
[picture p59: CAD file, 2026-10-24]
hardware/cad/export/stl/PROVISIONAL_carro_nano.stl
51.4 x 16.4 x 25.1
