Sopa-IA/Control-deck/hardware/cad/export/stl/PROVISIONAL_placa_puertos_pi.stl

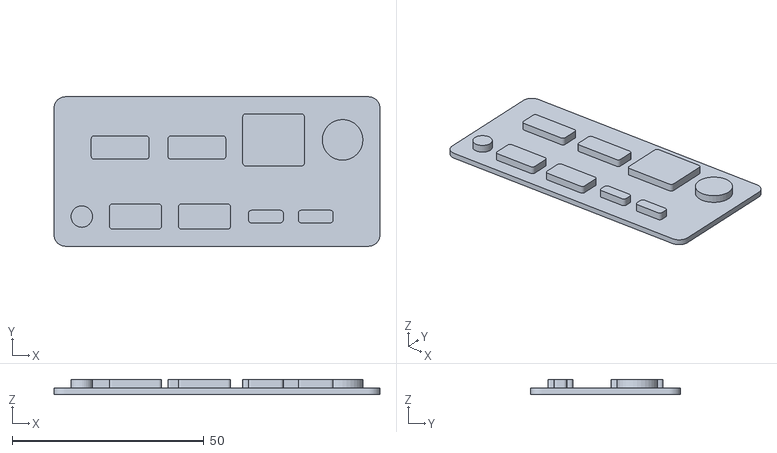
[picture p60: CAD file, 2026-10-24]
hardware/cad/export/stl/PROVISIONAL_placa_puertos_pi.stl
85.0 x 39.0 x 3.80
