Sopa-IA/Control-deck/hardware/cad/export/stl/PROVISIONAL_boton_encendido.stl

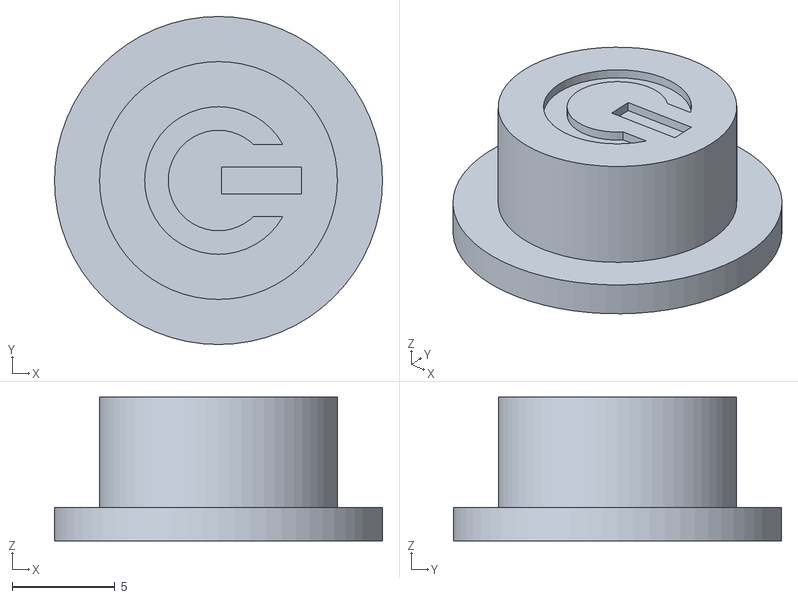
[picture p61: CAD file, 2026-10-24]
hardware/cad/export/stl/PROVISIONAL_boton_encendido.stl
16.0 x 16.0 x 7.00
