Sopa-IA/Control-deck/hardware/cad/export/stl/PROVISIONAL_pomo_x2.stl

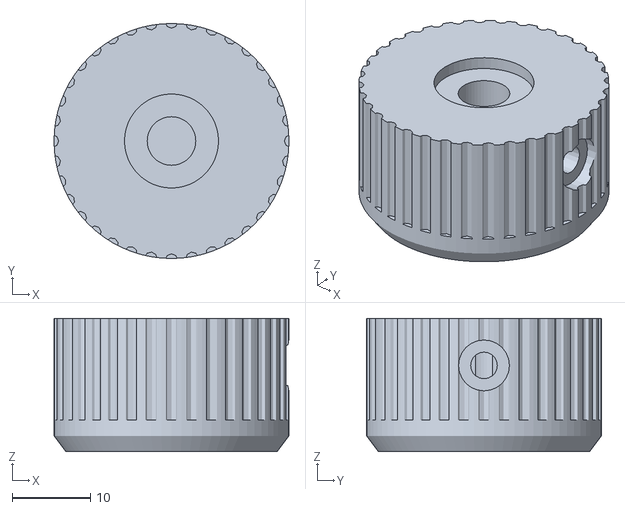
[picture p62: CAD file, 2026-10-24]
hardware/cad/export/stl/PROVISIONAL_pomo_x2.stl
30.0 x 30.0 x 17.0
