Sopa-IA/Control-deck/hardware/cad/export/stl/PROVISIONAL_panel_pines.stl

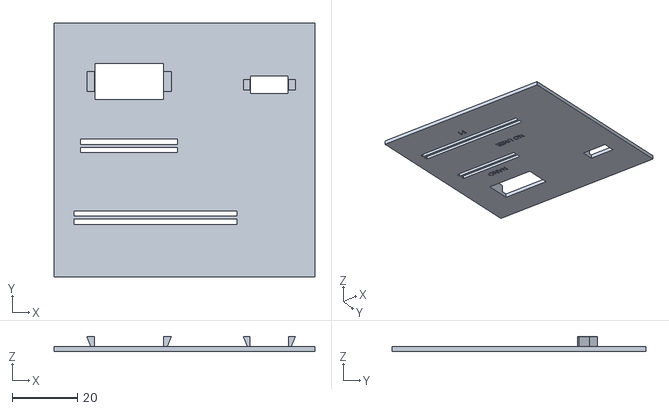
[picture p63: CAD file, 2026-10-24]
hardware/cad/export/stl/PROVISIONAL_panel_pines.stl
80.0 x 78.0 x 4.60
