Sopa-IA/Control-deck/(list of files, cad)

Other CAD files:
hardware/impresion/base/STEP/PRUEBA_plantilla_agujeros_HP.step
hardware/impresion/base/STEP/PROVISIONAL_base_x0_y0.step
hardware/impresion/siguientes/STEP/06_PROVISIONAL_carcasa_x1_y1.step
hardware/impresion/siguientes/STEP/03_PROVISIONAL_carcasa_x0_y1.step
hardware/impresion/siguientes/STEP/11_PROVISIONAL_guia_luz_frontal_0.step
hardware/impresion/siguientes/STEP/07_PROVISIONAL_bisel_x0_y0.step
hardware/impresion/siguientes/STEP/01_PRUEBA_plantilla_pivotes_HP.step
hardware/cad/export/stl/PROVISIONAL_carcasa_x1_y1.stl
hardware/impresion/siguientes/STEP/08_PROVISIONAL_bisel_x0_y1.step
hardware/cad/export/stl/PROVISIONAL_soporte_arduino.stl
hardware/cad/export/stl/PROVISIONAL_bisel_x0_y1.stl
hardware/cad/export/stl/PROVISIONAL_bisel_x1_y1.stl
hardware/cad/export/stl/PROVISIONAL_base_x0_y1.stl
hardware/cad/export/stl/PROVISIONAL_pletina_empalme_x4.stl
hardware/cad/export/stl/PROVISIONAL_carcasa_x1_y0.stl
hardware/cad/export/stl/PROVISIONAL_base_x1_y1.stl
hardware/cad/export/stl/PROVISIONAL_base_x0_y0.stl
hardware/cad/export/stl/PROVISIONAL_carcasa_x0_y1.stl
hardware/cad/export/stl/PROVISIONAL_bisel_x0_y0.stl
hardware/cad/export/stl/PROVISIONAL_anillo_luz_x2.stl
hardware/cad/export/stl/PROVISIONAL_carcasa_x0_y0.stl
hardware/cad/export/stl/PROVISIONAL_base_x1_y0.stl
hardware/cad/export/stl/PROVISIONAL_soporte_disco.stl
hardware/cad/export/stl/PROVISIONAL_bisel_x1_y0.stl
hardware/cad/export/stl/PROVISIONAL_guia_luz_frontal_0.stl
hardware/cad/export/stl/PROVISIONAL_guia_luz_frontal_1.stl
hardware/impresion/base/PRUEBA_pared_trasera_IO_HP.stl
