Sopa-IA/Control-deck/docs/manual_completo/README.md

# Orbit Terminal - Manual de montaje y software

Este es el manual vigente. Sustituye a `docs/manual_montaje/` y a `docs/manual-montaje/`.

La fuente es `hardware/cad/manual/completo_pdf.py` y `hardware/cad/manual/completo.scad`.
Para regenerarlo, desde la raíz del repo:

```
python3 hardware/cad/manual/completo_pdf.py
```

PDF: `docs/manual_completo/Orbit_manual_completo.pdf`. Páginas: 93. Pasos numerados: 79.

Cada paso numerado tiene su figura. Lo naranja es lo que se pone en ese paso. Las pantallas de Imager y las cajas de terminal son ilustraciones, rotuladas en la propia figura.

La carcasa y la base ya están impresas y cerradas. No se cortan, no se taladran y no se liman. La tapa de la Pi es la v2. La bandeja es la v3, con ventanas. El soporte de un ventilador soplante no existe: queda pendiente.

## Páginas

1. Portada
2. Cómo se lee
3. Piezas ya impresas
4. Piezas ya impresas, sigue
5. Piezas ya impresas, sigue
6. Piezas que se imprimen ahora
7. Piezas que se imprimen ahora, sigue
8. Piezas que se imprimen ahora, sigue
9. Electrónica
10. Electrónica, sigue
11. Tornillos de los kits
12. Tornillos de los kits, sigue
13. FALTA: comprar
14. 1. La carcasa ya está cerrada
15. 2. Imprime el marco frontal
16. 3. Mete el marco en la ventana
17. 4. El marco ya asienta
18. 5. Imprime la prueba de la placa I/O
19. 6. Apoya la prueba por fuera
20. 7. Imprime la placa I/O
21. 8. Mete la placa por dentro
22. 9. Imprime la tapa de agujeros viejos
23. 10. Mete la tapa por dentro
24. 11. Imprime la careta de pines
25. 12. Engancha la careta
26. 13. Mete la regleta 2×20
27. 14. Mete la regleta 2×12
28. 15. Imprime el capuchón
29. 16. Prueba el capuchón
30. 17. Mete el capuchón
31. 18. Imprime el soporte
32. 19. Pega el soporte
33. 20. Mete el pulsador y el LED
34. 21. Dos hilos al cabezal
35. 22. Imprime la bandeja v3
36. 23. Pon la Pi
37. 24. Cuatro M2.5×8
38. 25. Pon el ESP8266
39. 26. Cuatro grapas en el ESP
40. 27. Pon el Nano de mandos
41. 28. Cuatro grapas en mandos
42. 29. Ese módulo no es un step-down
43. 30. Pon el LM2596
44. 31. Dos M3×8 atraviesan el módulo
45. 32. Dos grapas en el step-down
46. 33. Pon el Nano de pruebas
47. 34. Cuatro grapas en pruebas
48. 35. Saca los cables por las ventanas
49. 36. Apoya la bandeja
50. 37. Cuatro M3×8 a la base
51. 38. Imprime la tapa v2
52. 39. Baja la tapa
53. 40. Dos M3×8 en los postes
54. 41. Imprime pomos y anillos
55. 42. Mete anillo y pomo
56. 43. Mete las guías de luz
57. 44. Mete el monitor
58. 45. Pon los cuatro biseles
59. 46. Cable de red
60. 47. Así se cablea
61. 48. La placa HP
62. 49. El disco Toshiba
63. 50. Soporte de soplante
64. 51. Qué necesitas
65. 52. Instala Imager
66. 53. Elige la Raspberry Pi 4
67. 54. Elige el sistema con escritorio
68. 55. Elige la microSD
69. 56. Pon usuario, Wi-Fi y SSH
70. 57. Escribe la tarjeta
71. 58. Primer arranque
72. 59. Entra por SSH
73. 60. Clona la rama
74. 61. Entra en la carpeta
75. 62. Lanza el instalador
76. 63. Reinicia
77. 64. SSH otra vez
78. 65. Empareja el teclado Bluetooth
79. 66. orbitd está activo
80. 67. El Wi-Fi tiene internet
81. 68. eth0 no tiene puerta
82. 69. Estás en dialout
83. 70. Apagar pide confirmación
84. 71. El botón corto no apaga
85. 72. Empareja Moonlight una vez
86. 73. Salir y volver al kiosco
87. 74. El simulador no apaga el PC
88. 75. Instala Sunshine
89. 76. Empareja con el PIN
90. 77. Instala hp-agent
91. 78. Vista integrada
92. 79. Enchufe HDMI falso
93. Si algo no cuadra
