Sopa-IA/Control-deck/docs/manual-montaje/README.md

# Manual de montaje antiguo

**Sustituido.** El manual vigente es [Orbit Terminal - Manual de montaje y software](../manual_completo/Orbit_manual_completo.pdf), en `docs/manual_completo/`.

`MANUAL_MONTAJE_ORBIT.pdf` se queda aquí como historial. No lo uses para montar.
