Sopa-IA/Control-deck/hardware/impresion/siguientes/STEP/COMPROBACION_STEP.txt

COMPROBACIÓN DE LOS STEP · 20/10/2026 · FreeCAD 1.0, esquema AP214 (AUTOMOTIVE_DESIGN)
Método: cada STEP se reabre con FreeCAD (Part.read). Se mira si el sólido es válido (isValid),
si las cáscaras están cerradas, y se compara la caja envolvente y el volumen con la STL de al lado.
origen csg = sólido desde el código OpenSCAD (importador CSG de FreeCAD); malla = desde la STL.

En el repo las rutas del paquete de origen quedan así (el nombre de archivo no cambia):
  STEP_SolidWorks/            -> hardware/impresion/siguientes/STEP/
  BASE_ya_impresa/STEP_SolidWorks/ -> hardware/impresion/base/STEP/
Los STL no se duplican: están en hardware/cad/export/stl/ y en hardware/impresion/.
El detalle de impresión está en hardware/impresion/siguientes/README.md.

archivo                                                        origen válido cuerpos caras  curvas caja STEP (mm)           dif.caja vol STEP/STL cm3
STEP_SolidWorks/01_PRUEBA_plantilla_pivotes_HP.step            csg    SÍ     1       36     12     164.48x161.94x7.6        0.0      8.38/8.38
STEP_SolidWorks/02_PROVISIONAL_bandeja_servicio.step           csg    SÍ     3       721    24     141.0x237.49x14.0        0.001    154.08/154.07
STEP_SolidWorks/03_PROVISIONAL_carcasa_x0_y1.step              malla  SÍ     1       1623   0      228.13x150.25x150.93     0.0      213.68/213.68
STEP_SolidWorks/04_PROVISIONAL_carcasa_x0_y0.step              malla  SÍ     1       1431   0      228.13x150.25x95.36      0.0      104.65/104.65
STEP_SolidWorks/05_PROVISIONAL_carcasa_x1_y0.step              malla  NO     1       2629   0      228.13x150.25x95.36      0.0      115.54/115.54
STEP_SolidWorks/06_PROVISIONAL_carcasa_x1_y1.step              malla  SÍ     1       2911   0      228.13x150.25x150.93     0.0      243.84/243.83
STEP_SolidWorks/07_PROVISIONAL_bisel_x0_y0.step                malla  SÍ     1       599    0      190.83x126.62x3.6        0.0      24.89/24.89
STEP_SolidWorks/08_PROVISIONAL_bisel_x0_y1.step                malla  SÍ     1       599    0      190.83x126.62x3.6        0.0      24.89/24.89
STEP_SolidWorks/09_PROVISIONAL_bisel_x1_y0.step                malla  SÍ     1       599    0      190.83x126.62x3.6        0.0      24.89/24.89
STEP_SolidWorks/10_PROVISIONAL_bisel_x1_y1.step                malla  SÍ     1       434    0      190.83x126.62x3.6        0.0      22.81/22.81
STEP_SolidWorks/11_PROVISIONAL_guia_luz_frontal_0.step         csg    SÍ     1       13     0      201.13x9.0x6.95          0.0      9.82/9.82
STEP_SolidWorks/12_PROVISIONAL_guia_luz_frontal_1.step         csg    SÍ     1       13     0      201.13x9.0x6.95          0.0      9.82/9.82
STEP_SolidWorks/13_PROVISIONAL_anillo_luz_x2.step              csg    SÍ     1       21     5      41.0x41.0x5.6            0.0      1.82/1.82
STEP_SolidWorks/14_PROVISIONAL_pomo_x2.step                    csg    SÍ     1       195    6      30.0x30.0x17.0           0.0      11.02/11.02
STEP_SolidWorks/15_PROVISIONAL_soporte_arduino.step            csg    SÍ     1       171    4      25.7x70.0x19.1           0.001    9.52/9.52
BASE_ya_impresa/STEP_SolidWorks/PROVISIONAL_base_x0_y0.step    malla  SÍ     1       920    0      228.13x150.13x10.35      0.0      134.18/134.18
BASE_ya_impresa/STEP_SolidWorks/PROVISIONAL_base_x0_y1.step    malla  SÍ     1       1448   0      228.13x150.13x10.35      0.0      113.28/113.28
BASE_ya_impresa/STEP_SolidWorks/PROVISIONAL_base_x1_y0.step    malla  SÍ     1       872    0      228.13x150.13x8.99       0.0      92.83/92.83
BASE_ya_impresa/STEP_SolidWorks/PROVISIONAL_base_x1_y1.step    malla  SÍ     1       813    0      228.13x150.13x8.99       0.0      81.02/81.02
BASE_ya_impresa/STEP_SolidWorks/PROVISIONAL_pletina_empalme_x4.step csg    SÍ     1       132    2      30.0x10.0x3.0            0.001    0.84/0.84
BASE_ya_impresa/STEP_SolidWorks/PROVISIONAL_soporte_disco.step csg    SÍ     1       535    8      111.6x147.0x17.99        0.001    18.64/18.64
BASE_ya_impresa/STEP_SolidWorks/PRUEBA_pared_trasera_IO_HP.step malla  SÍ     1       243    0      228.13x92.01x15.0        0.0      47.92/47.92
BASE_ya_impresa/STEP_SolidWorks/PRUEBA_plantilla_agujeros_HP.step csg    SÍ     1       34     8      170.0x170.0x4.6          0.0      9.2/9.2

05_PROVISIONAL_carcasa_x1_y0: válido = NO por 12 triángulos que se cruzan en la STL original (plano x≈406,3).
02_PROVISIONAL_bandeja_servicio: 3 cuerpos porque la STL trae 2 torretas sueltas fuera de la bandeja (ver LEEME).
