Sopa-IA/Control-deck/docs/manual_completo/img/p_anillo.png

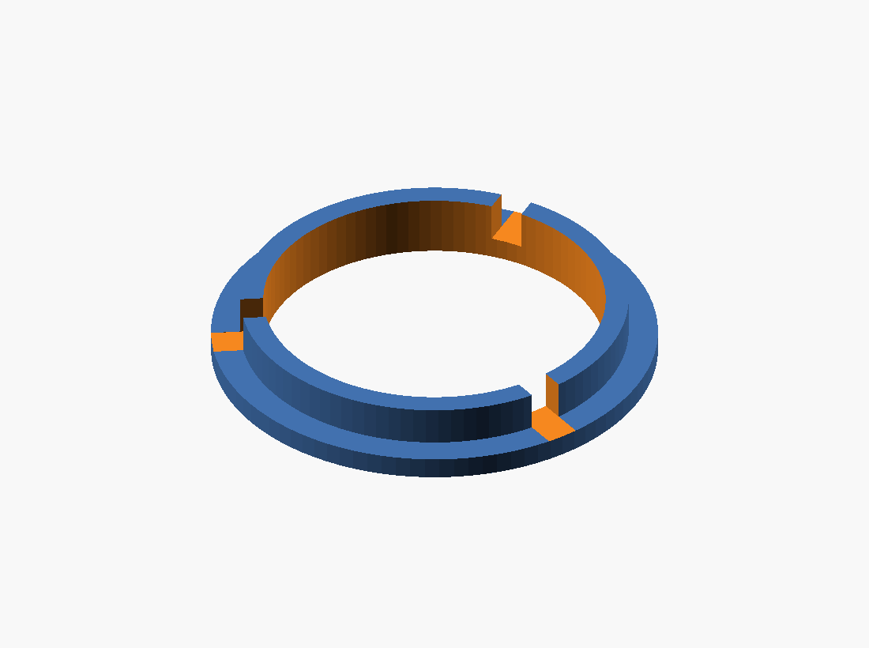
docs/manual_completo/img/p_anillo.png
