Sopa-IA/Control-deck/docs/manual_completo/img/p_bandeja.png

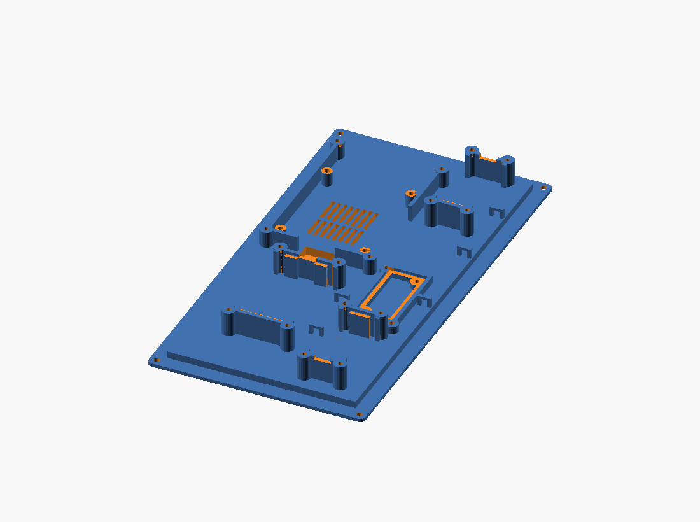
docs/manual_completo/img/p_bandeja.png
