Sopa-IA/Control-deck/docs/manual_completo/img/p_base_00.png

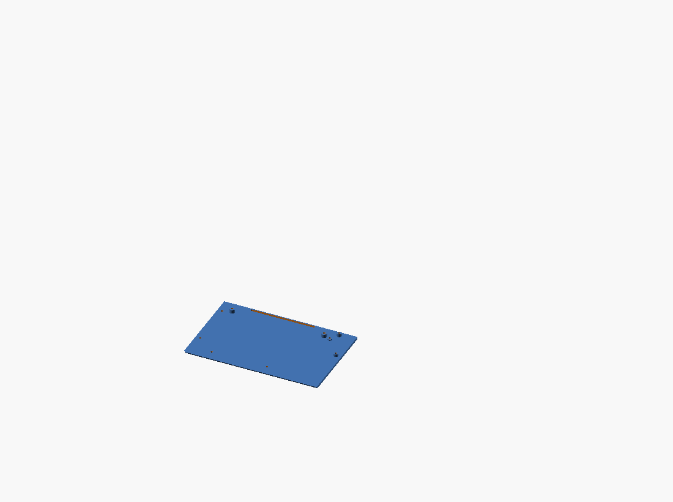
docs/manual_completo/img/p_base_00.png
