Sopa-IA/Control-deck/docs/manual_completo/img/p_base_10.png

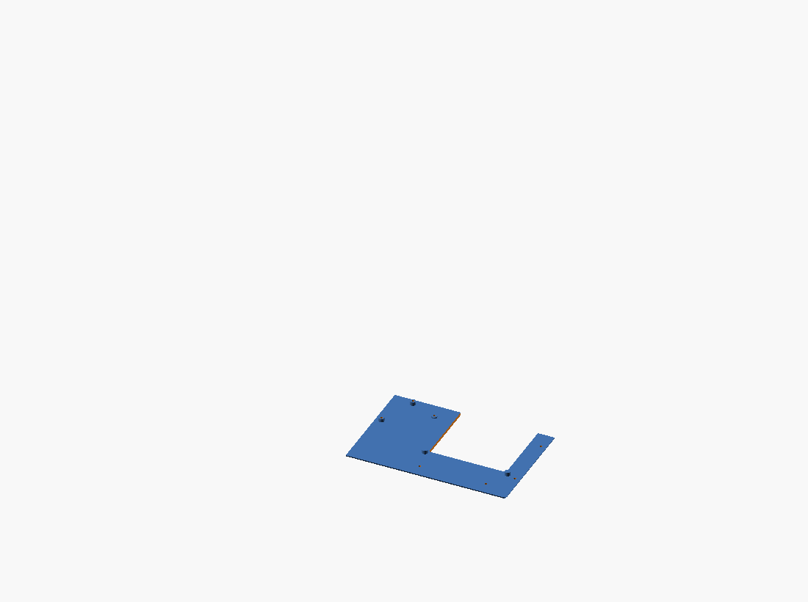
docs/manual_completo/img/p_base_10.png
