Sopa-IA/Control-deck/docs/manual_completo/img/p_bisel_01.png

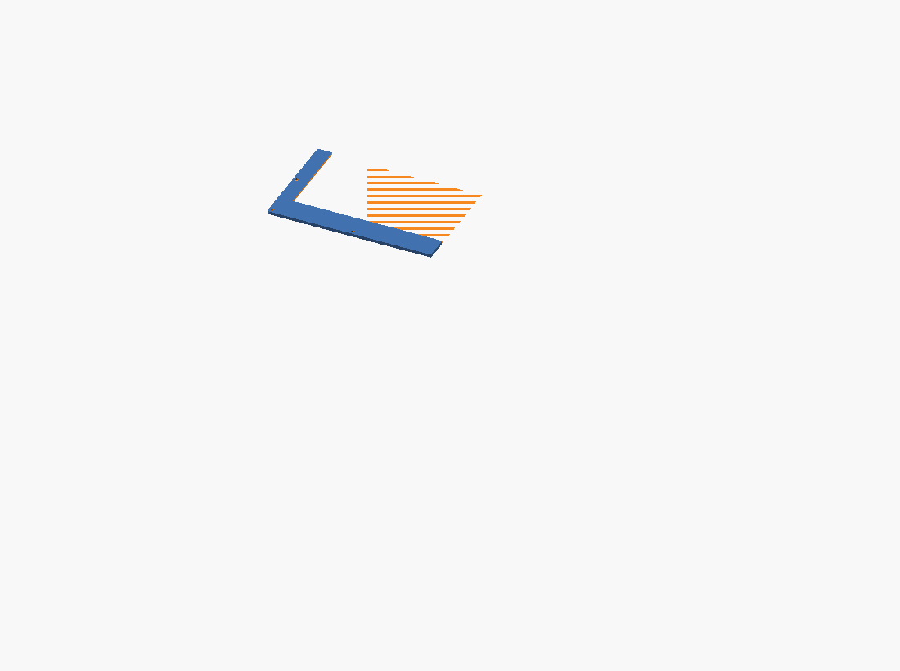
docs/manual_completo/img/p_bisel_01.png
