Sopa-IA/Control-deck/docs/manual_completo/img/p_bisel_11.png

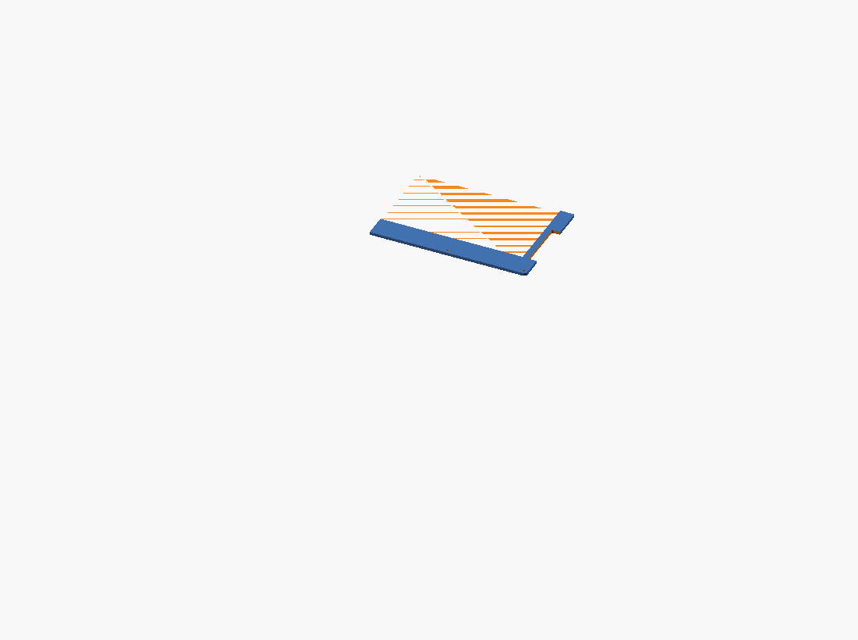
docs/manual_completo/img/p_bisel_11.png
