Sopa-IA/Control-deck/docs/manual_completo/img/p_boton.png

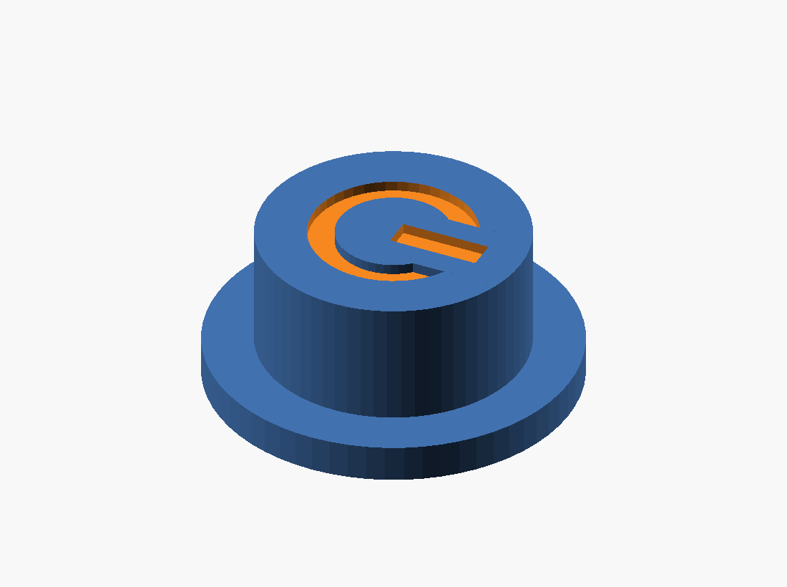
docs/manual_completo/img/p_boton.png
