Sopa-IA/Control-deck/docs/manual_completo/img/p_carcasa_01.png

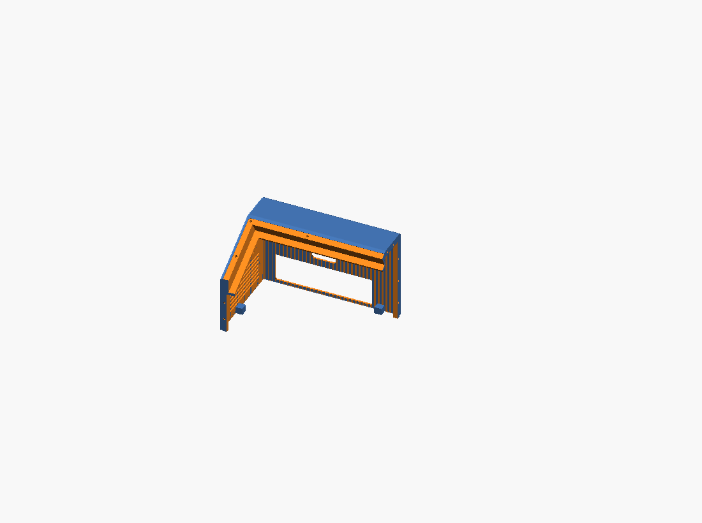
docs/manual_completo/img/p_carcasa_01.png
