Sopa-IA/Control-deck/docs/manual_completo/img/p_carcasa_11.png

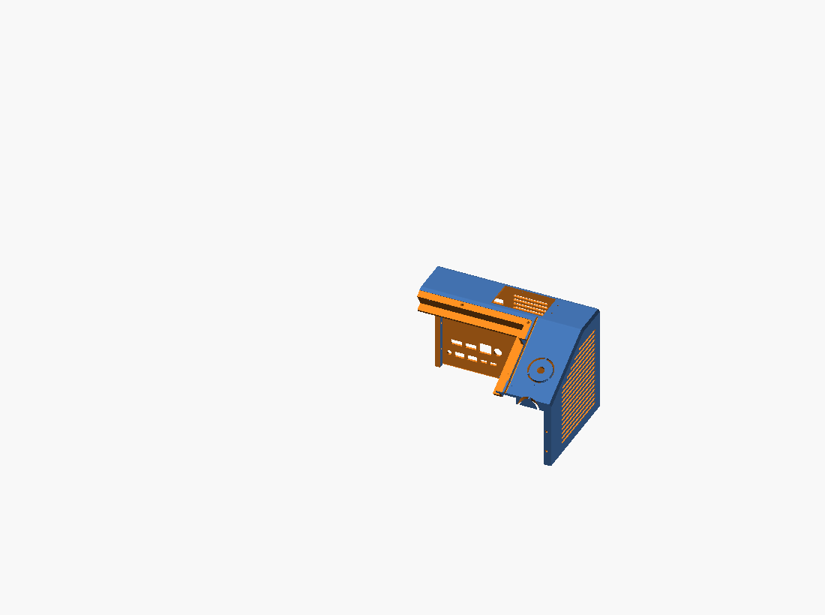
docs/manual_completo/img/p_carcasa_11.png
