Sopa-IA/Control-deck/docs/manual_completo/img/p_disco.png

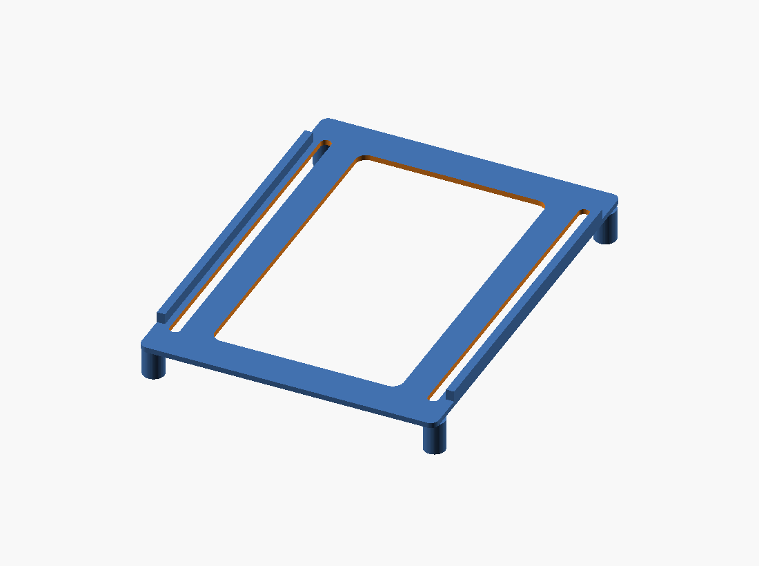
docs/manual_completo/img/p_disco.png
