Sopa-IA/Control-deck/docs/manual_completo/img/p_guia0.png

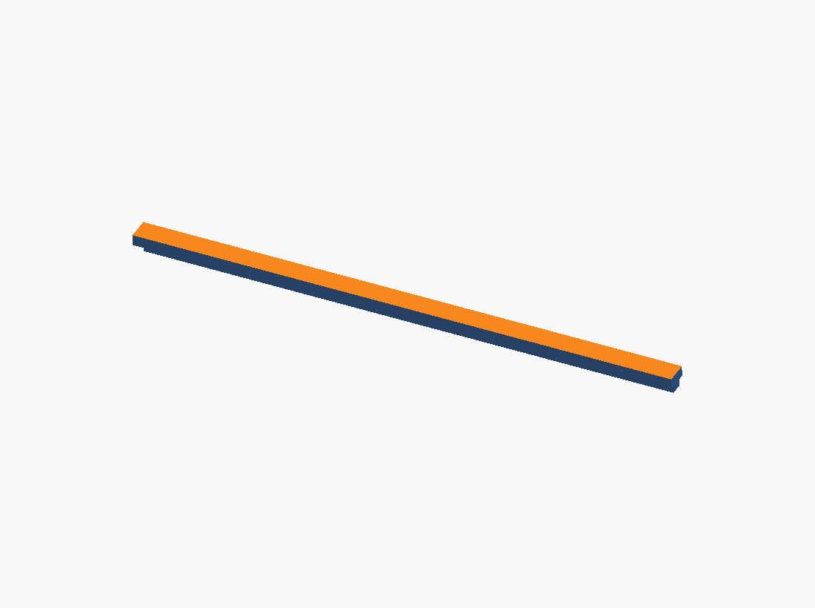
docs/manual_completo/img/p_guia0.png
