Sopa-IA/Control-deck/docs/manual_completo/img/p_marco.png

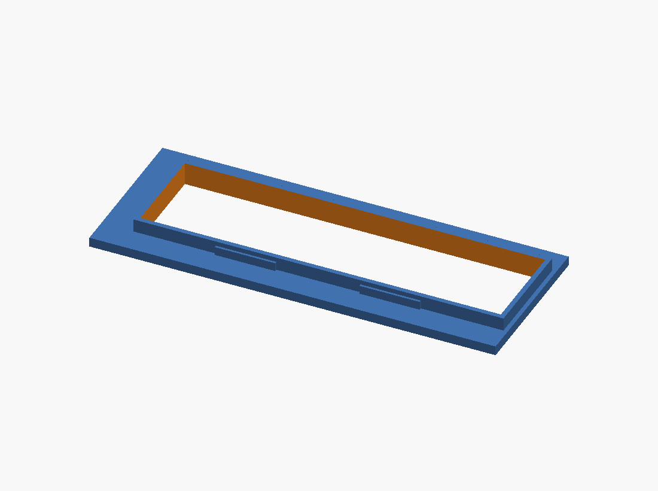
docs/manual_completo/img/p_marco.png
