Sopa-IA/Control-deck/docs/manual_completo/img/p_panel.png

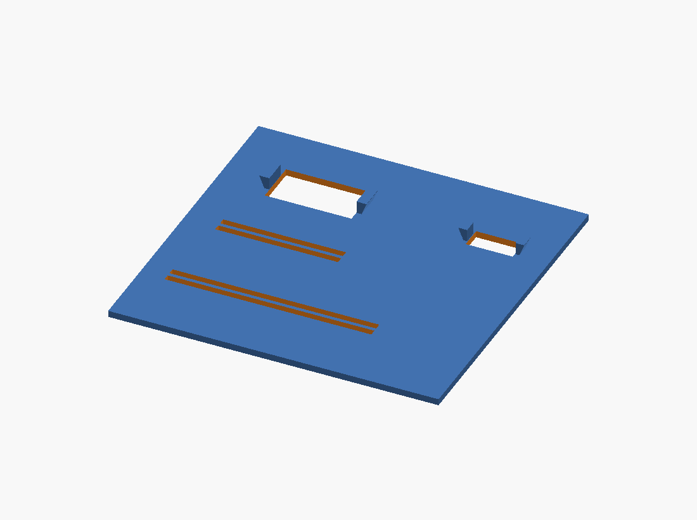
docs/manual_completo/img/p_panel.png
