Sopa-IA/Control-deck/docs/manual_completo/img/p_placa_io.png

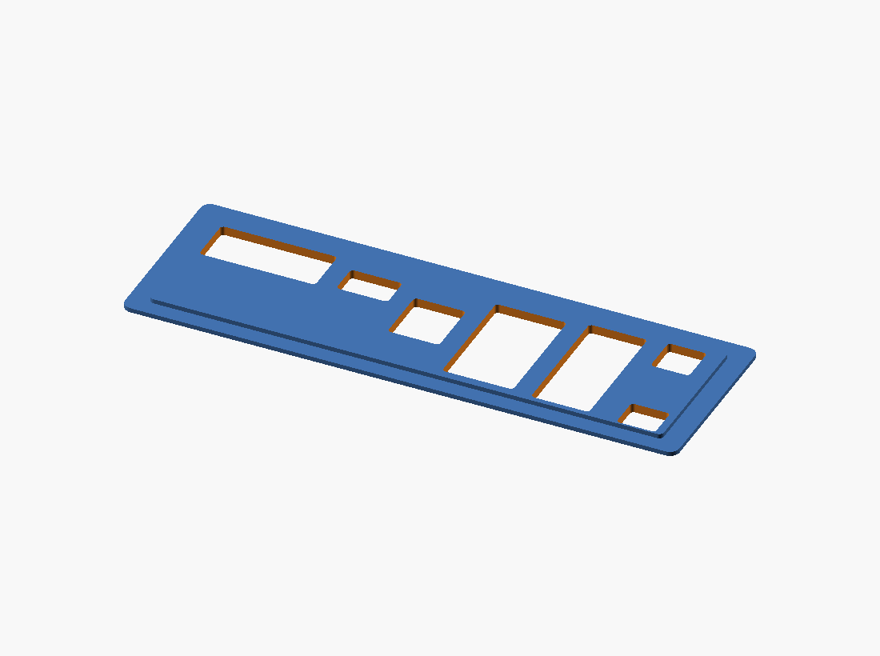
docs/manual_completo/img/p_placa_io.png
