Sopa-IA/Control-deck/docs/manual_completo/img/p_pletina.png

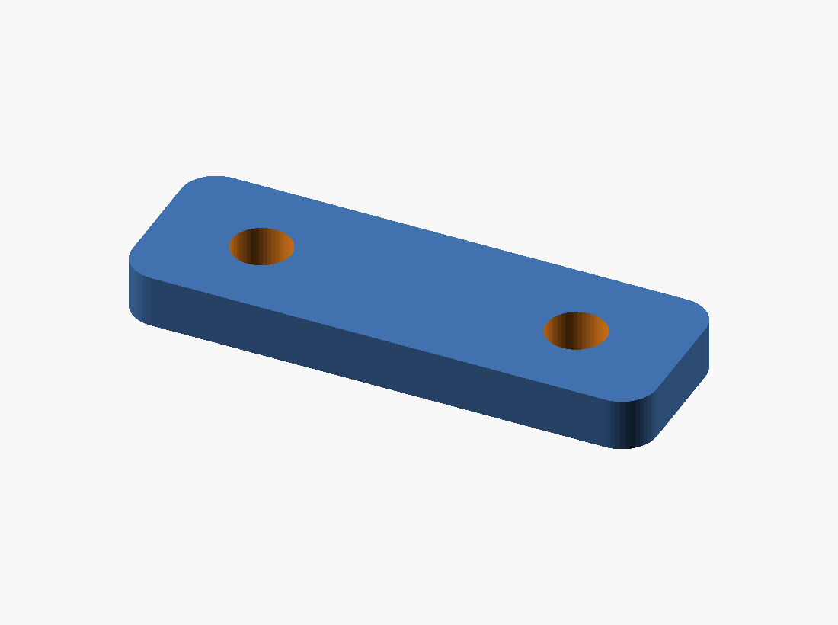
docs/manual_completo/img/p_pletina.png
