Sopa-IA/Control-deck/docs/manual_completo/img/p_pomo.png

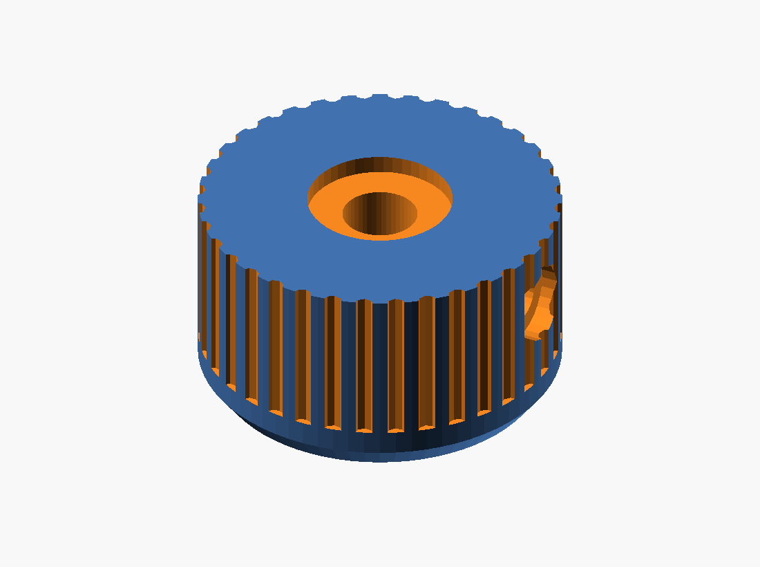
docs/manual_completo/img/p_pomo.png
