Sopa-IA/Control-deck/docs/manual_completo/img/p_soporte_b.png

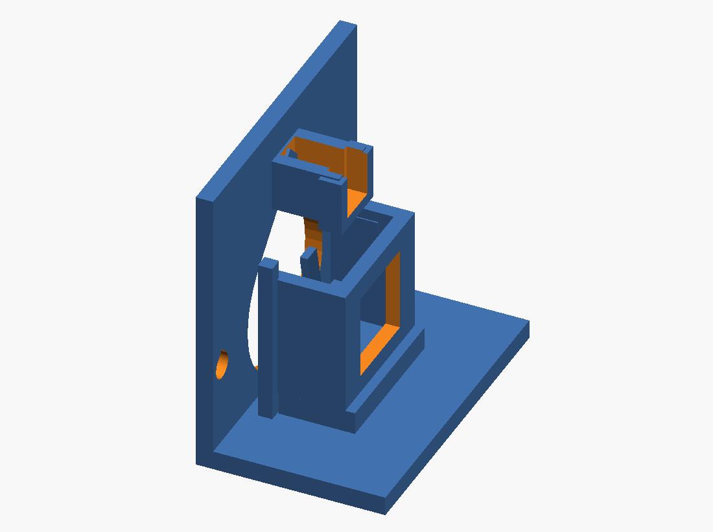
docs/manual_completo/img/p_soporte_b.png
