Sopa-IA/Control-deck/docs/manual_completo/img/p_tapa.png

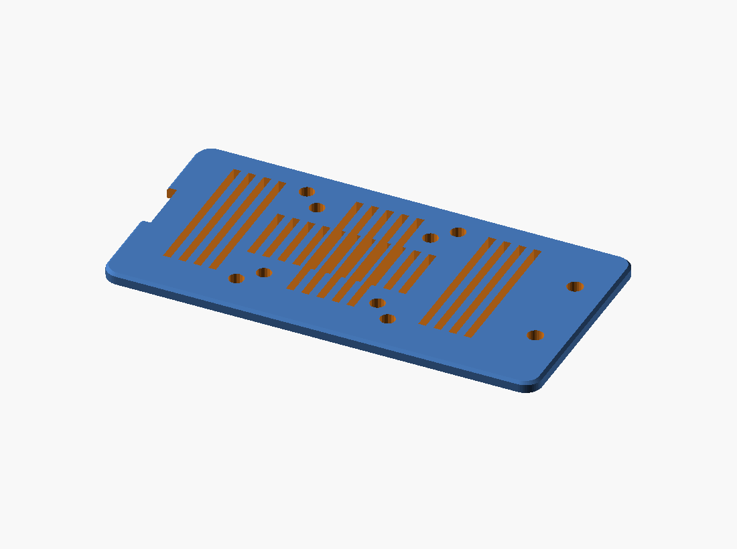
docs/manual_completo/img/p_tapa.png
