Sopa-IA/Control-deck/docs/manual_completo/img/tor_cap.png

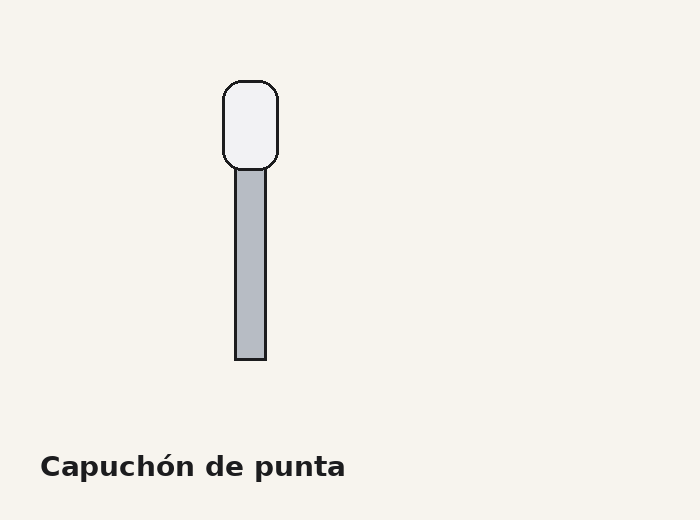
docs/manual_completo/img/tor_cap.png
