Sopa-IA/Control-deck/docs/manual_completo/img/tor_cs6.png

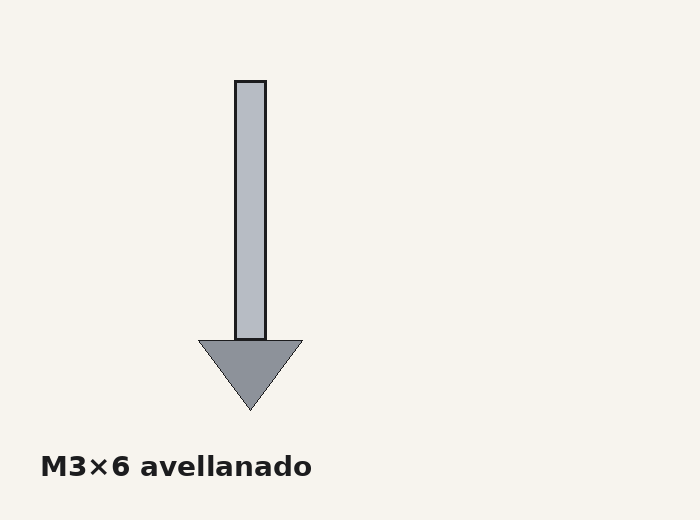
docs/manual_completo/img/tor_cs6.png
