Sopa-IA/Control-deck/docs/manual_completo/img/tor_tuerca.png

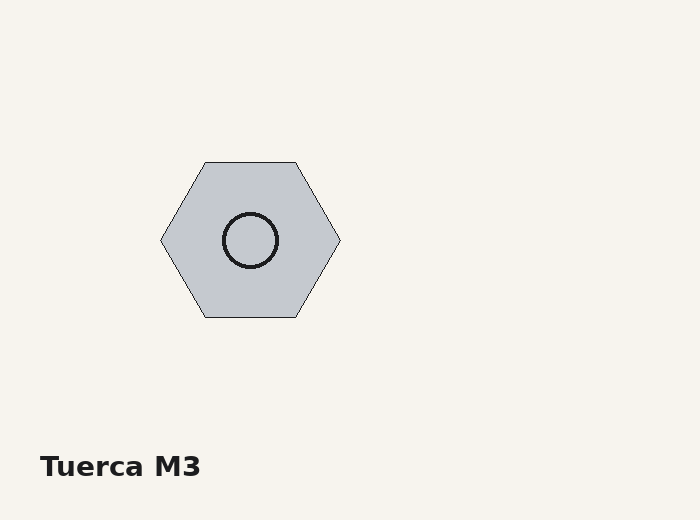
docs/manual_completo/img/tor_tuerca.png
