Sopa-IA/Control-deck/docs/manual_completo/img/v_anillo_pomo.png

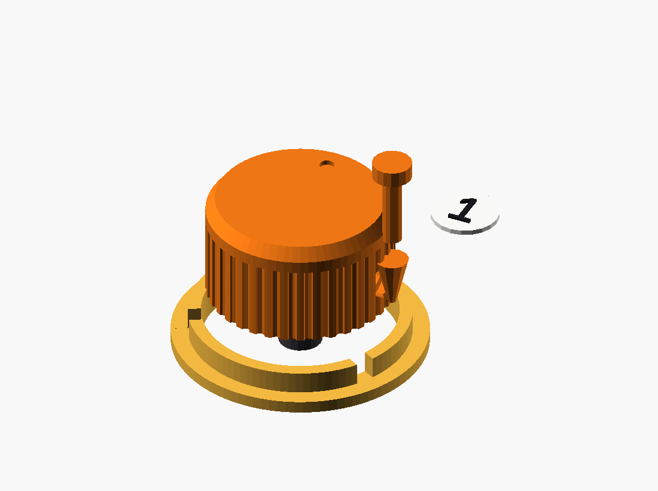
docs/manual_completo/img/v_anillo_pomo.png
