Sopa-IA/Control-deck/docs/manual_completo/img/v_bandeja_torres.png

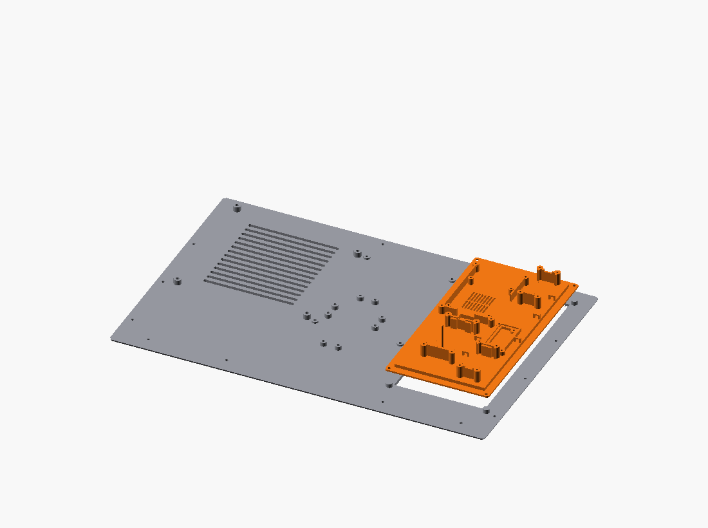
docs/manual_completo/img/v_bandeja_torres.png
