Sopa-IA/Control-deck/docs/manual_completo/img/v_bisel.png

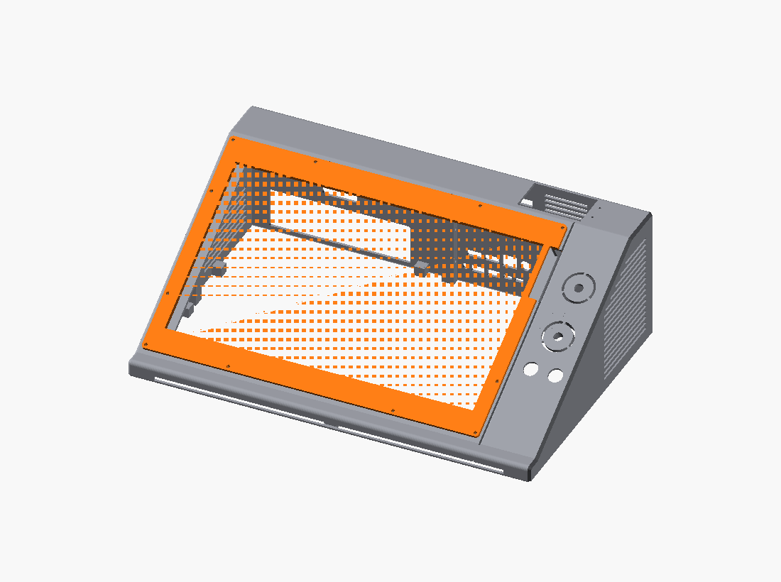
docs/manual_completo/img/v_bisel.png
