Sopa-IA/Control-deck/docs/manual_completo/img/v_buck_grapa.png

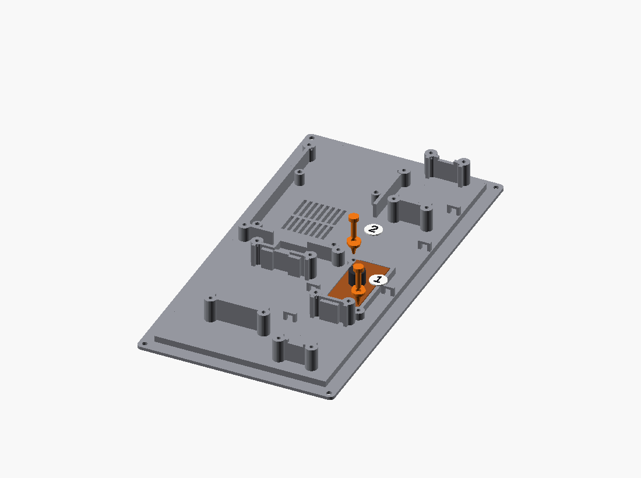
docs/manual_completo/img/v_buck_grapa.png
