Sopa-IA/Control-deck/docs/manual_completo/img/v_cable_eth.png

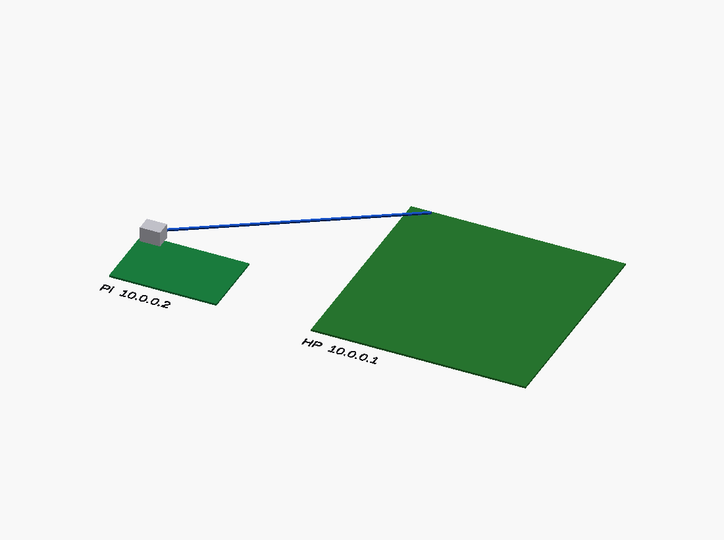
docs/manual_completo/img/v_cable_eth.png
