Sopa-IA/Control-deck/docs/manual_completo/img/v_capuchon.png

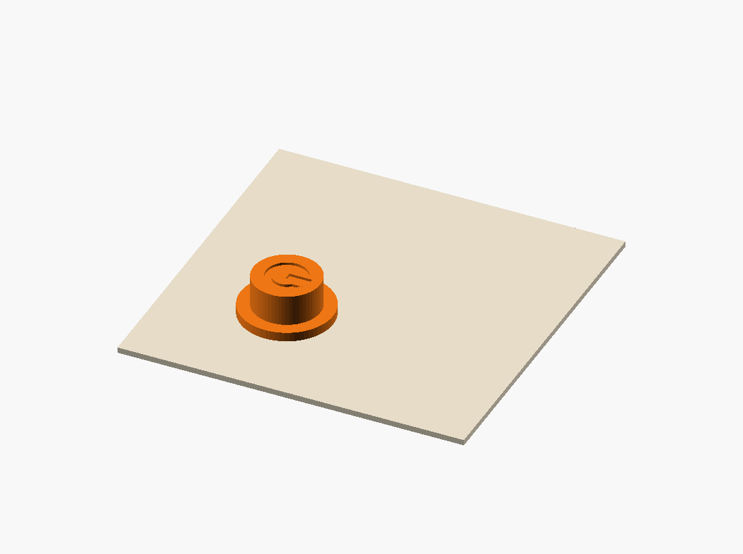
docs/manual_completo/img/v_capuchon.png
