Sopa-IA/Control-deck/docs/manual_completo/img/v_diagrama.png

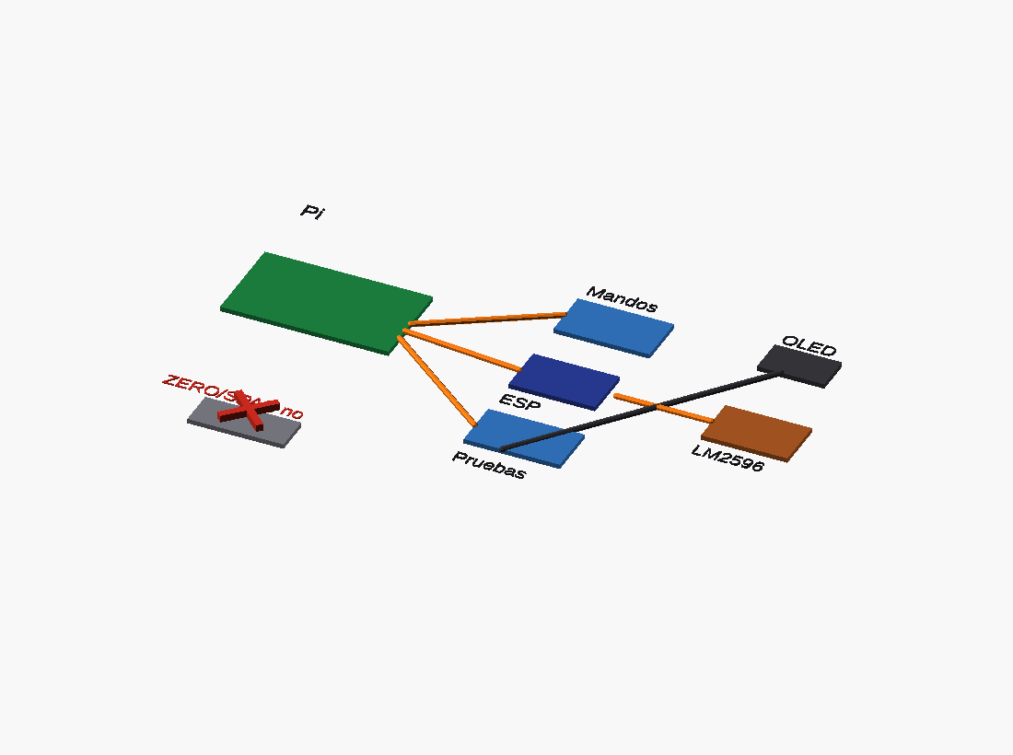
docs/manual_completo/img/v_diagrama.png
