Sopa-IA/Control-deck/docs/manual_completo/img/v_elec_fan.png

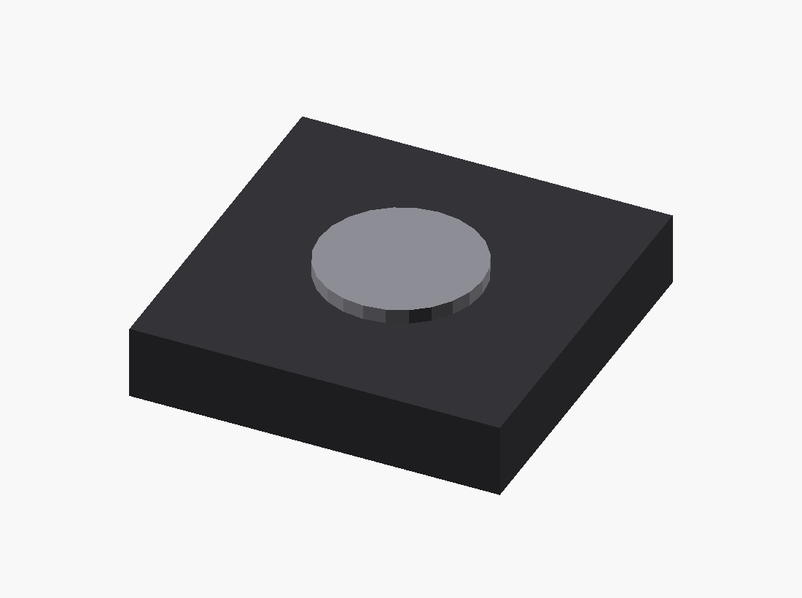
docs/manual_completo/img/v_elec_fan.png
