Sopa-IA/Control-deck/docs/manual_completo/img/v_elec_hat.png

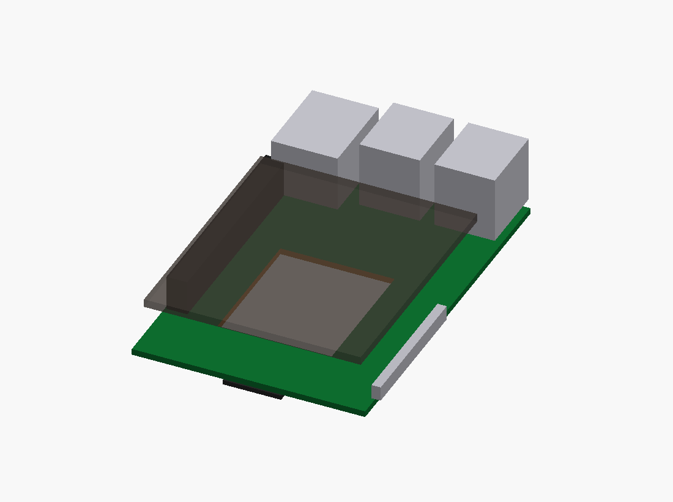
docs/manual_completo/img/v_elec_hat.png
