Sopa-IA/Control-deck/docs/manual_completo/img/v_elec_hdd.png

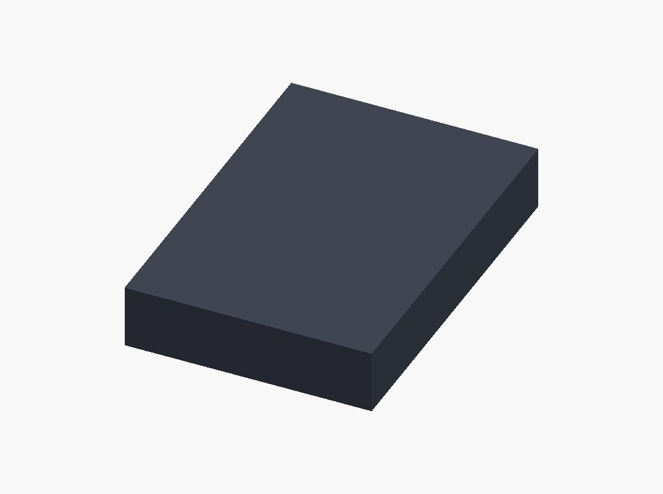
docs/manual_completo/img/v_elec_hdd.png
