Sopa-IA/Control-deck/docs/manual_completo/img/v_elec_hp.png

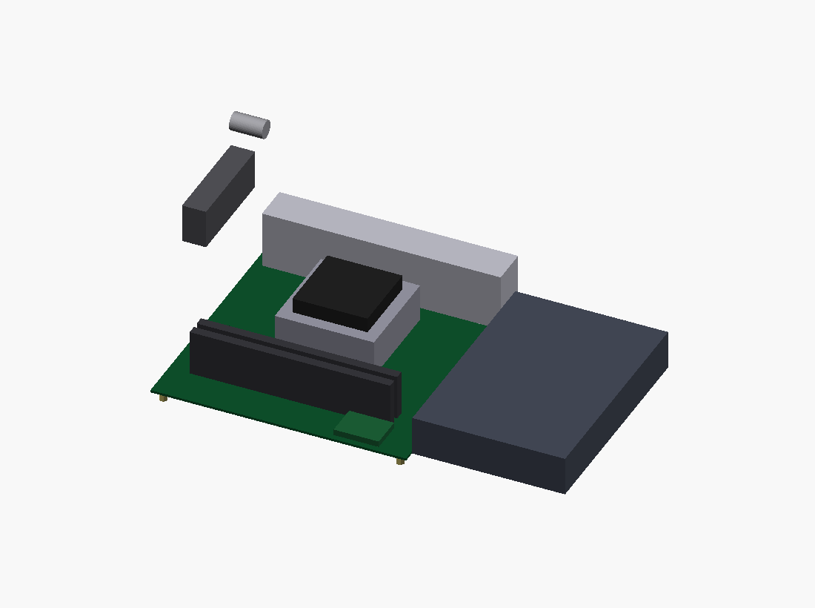
docs/manual_completo/img/v_elec_hp.png
