Sopa-IA/Control-deck/docs/manual_completo/img/v_elec_oled.png

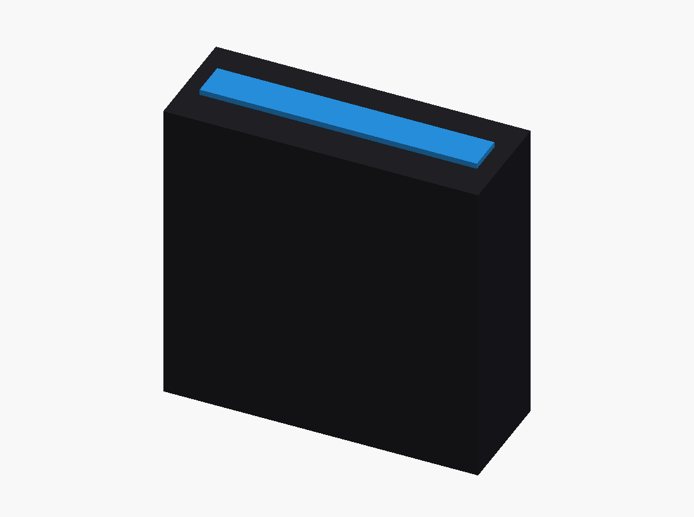
docs/manual_completo/img/v_elec_oled.png
