Sopa-IA/Control-deck/docs/manual_completo/img/v_faltan_632.png

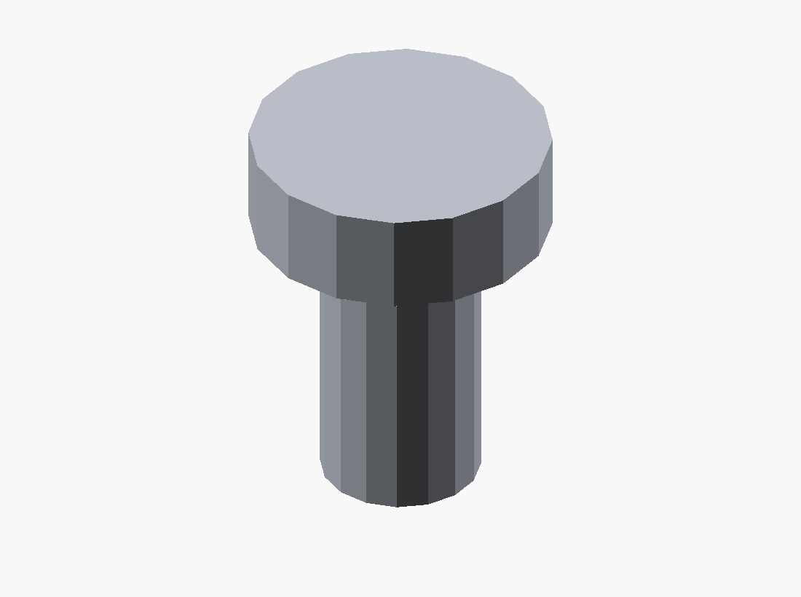
docs/manual_completo/img/v_faltan_632.png
