Sopa-IA/Control-deck/docs/manual_completo/img/v_faltan_dupont.png

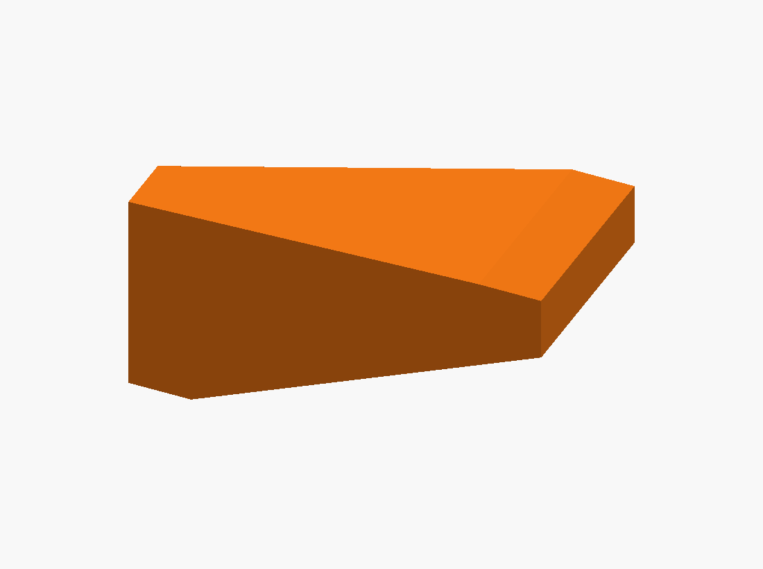
docs/manual_completo/img/v_faltan_dupont.png
