Sopa-IA/Control-deck/docs/manual_completo/img/v_hilos_boton.png

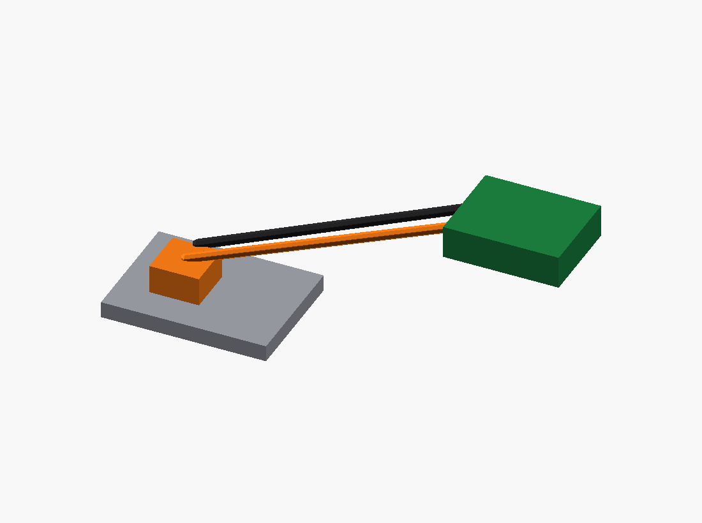
docs/manual_completo/img/v_hilos_boton.png
