Sopa-IA/Control-deck/docs/manual_completo/img/v_marco_dentro.png

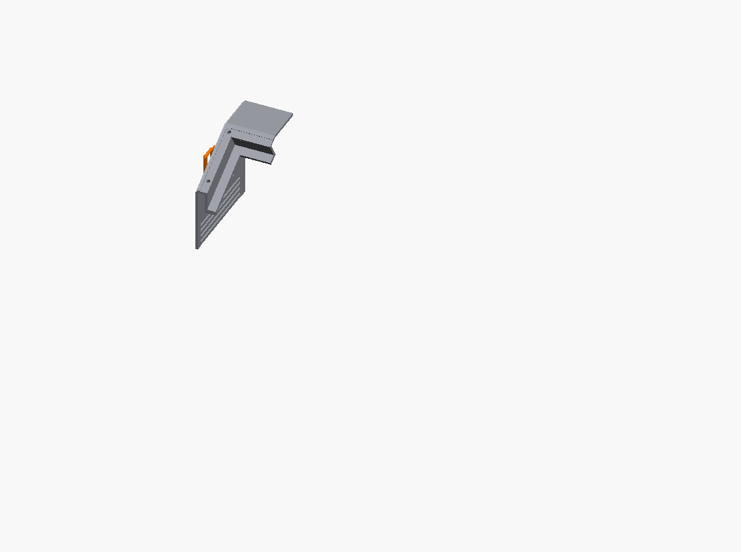
docs/manual_completo/img/v_marco_dentro.png
