Sopa-IA/Control-deck/docs/manual_completo/img/v_monitor.png

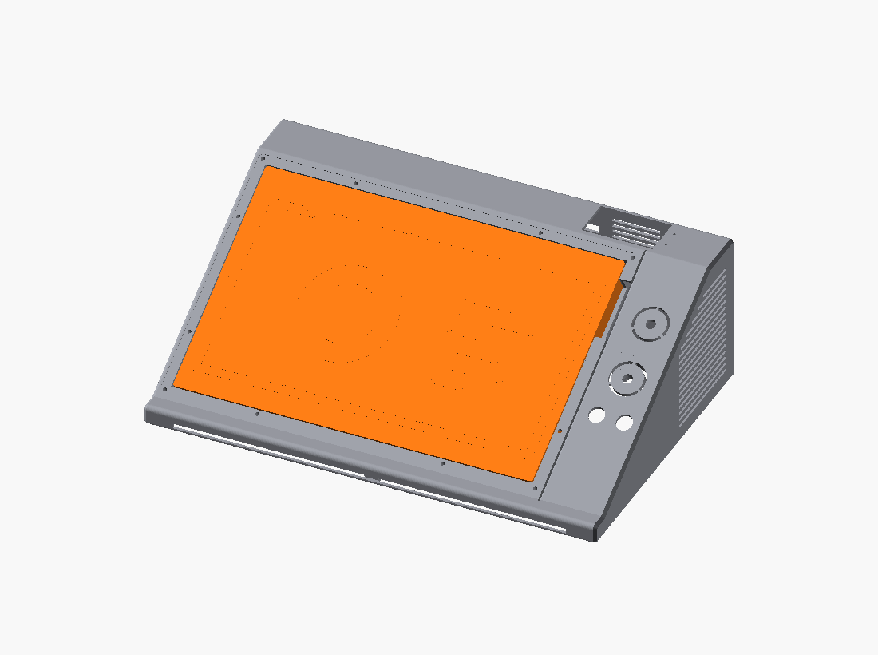
docs/manual_completo/img/v_monitor.png
