Sopa-IA/Control-deck/docs/manual_completo/img/v_placa_io.png

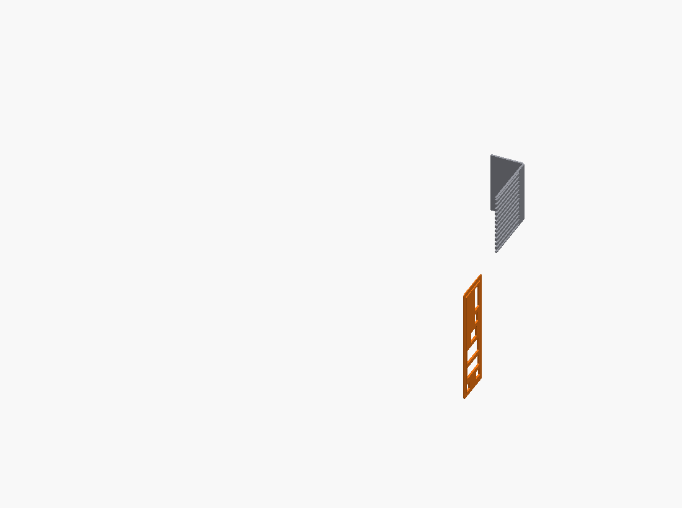
docs/manual_completo/img/v_placa_io.png
