Sopa-IA/Control-deck/docs/manual_completo/img/v_pulsador.png

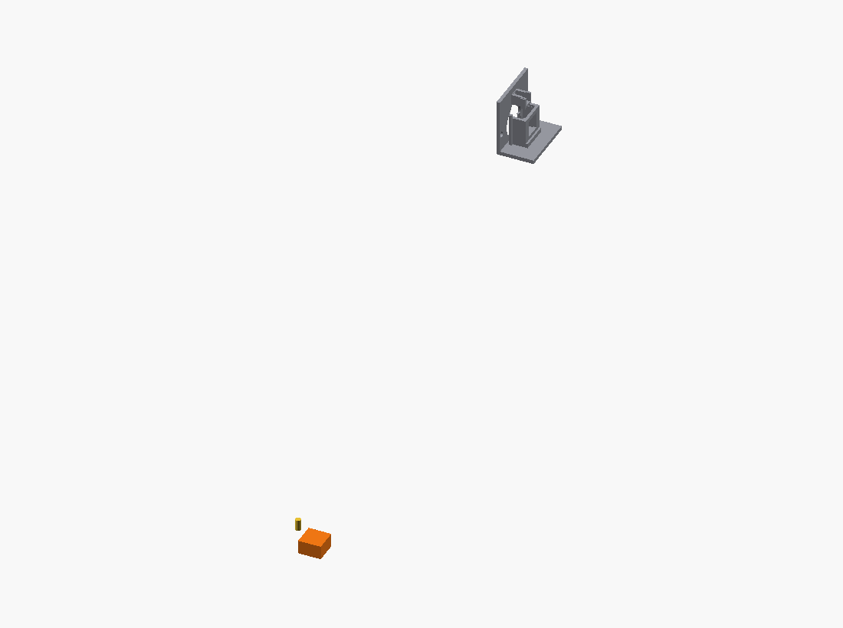
docs/manual_completo/img/v_pulsador.png
