Sopa-IA/Control-deck/docs/manual_completo/img/v_regleta12.png

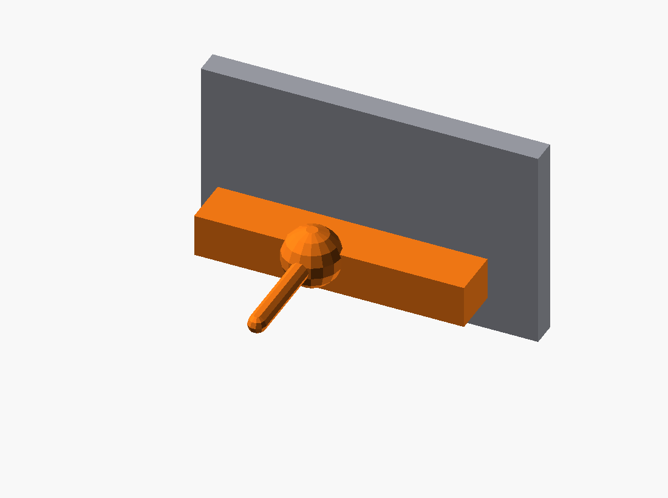
docs/manual_completo/img/v_regleta12.png
