Sopa-IA/Control-deck/docs/manual_completo/img/v_regleta20.png

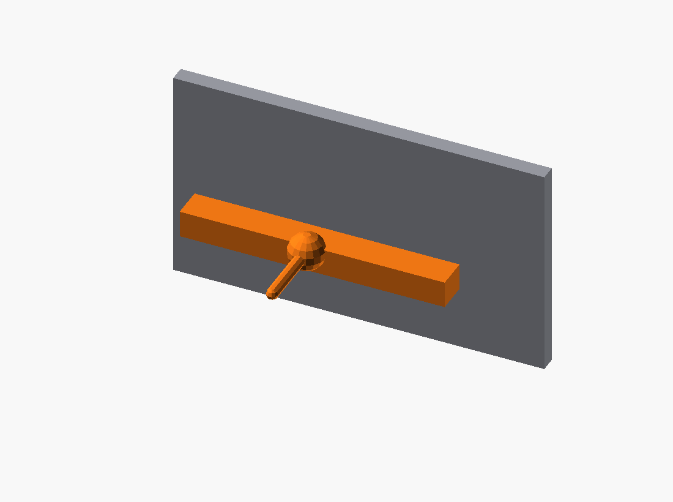
docs/manual_completo/img/v_regleta20.png
