Sopa-IA/Control-deck/docs/manual_completo/img/v_soporte_boton.png

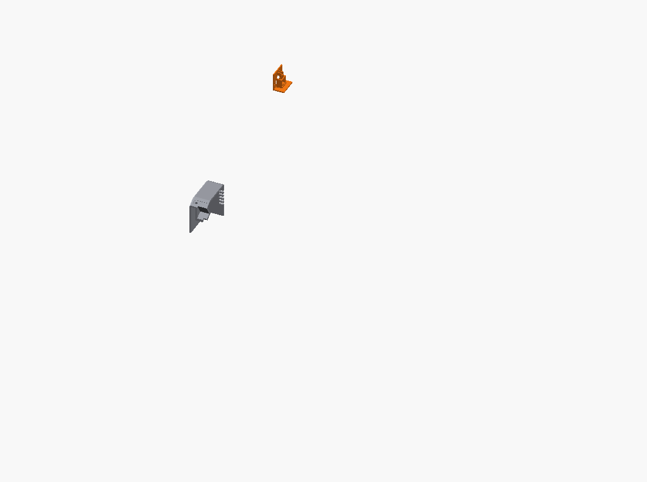
docs/manual_completo/img/v_soporte_boton.png
