Sopa-IA/Control-deck/docs/manual_completo/img/v_tapa_cama.png

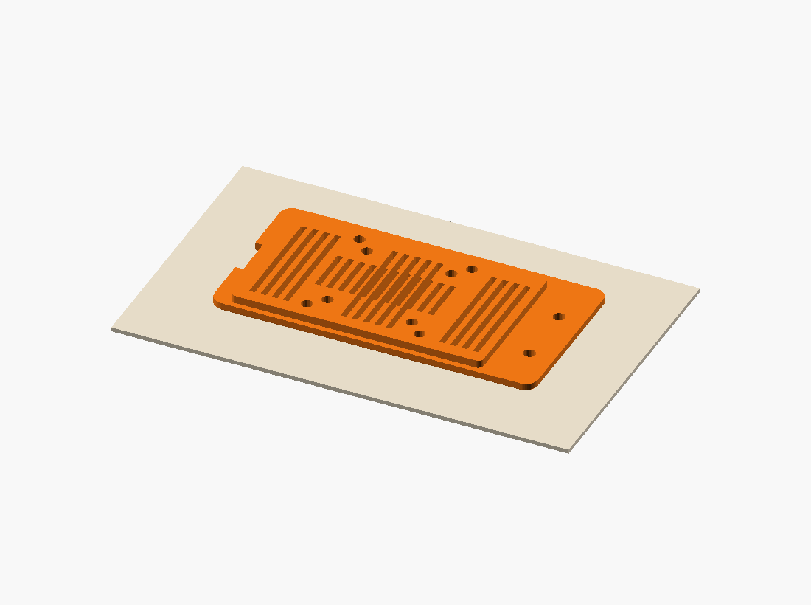
docs/manual_completo/img/v_tapa_cama.png
