Sopa-IA/Control-deck/docs/manual_completo/img/v_tapa_puertos.png

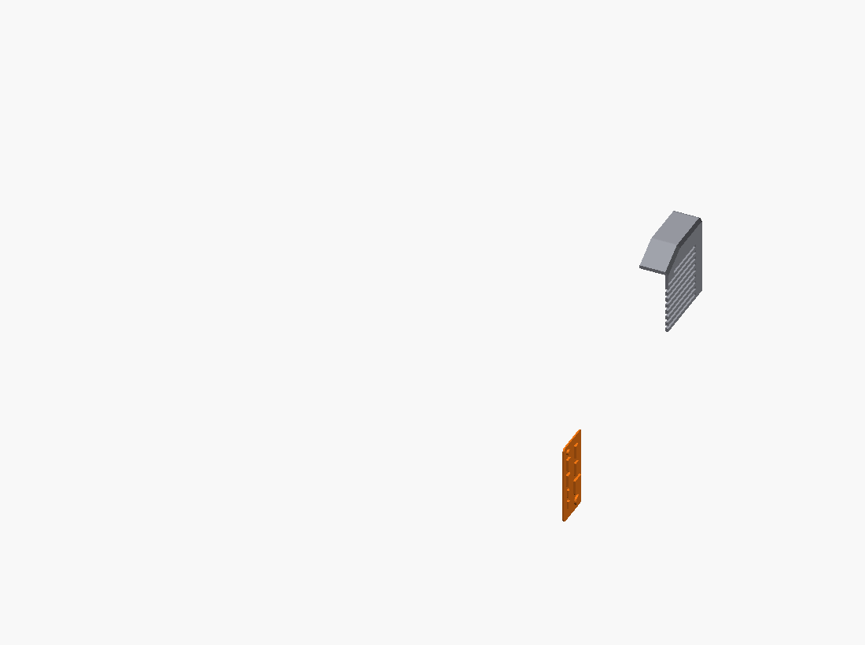
docs/manual_completo/img/v_tapa_puertos.png
