Sopa-IA/Control-deck/docs/manual_completo/img/p_prueba_b.png

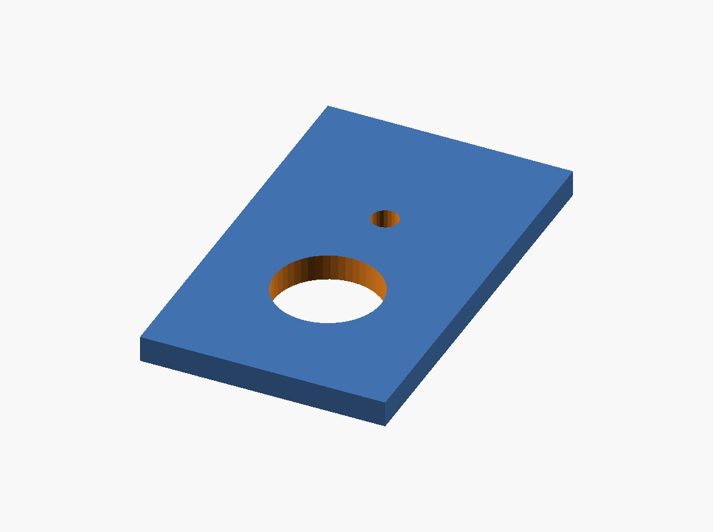
docs/manual_completo/img/p_prueba_b.png
