Sopa-IA/Control-deck/docs/manual_completo/img/v_prueba_boton.png

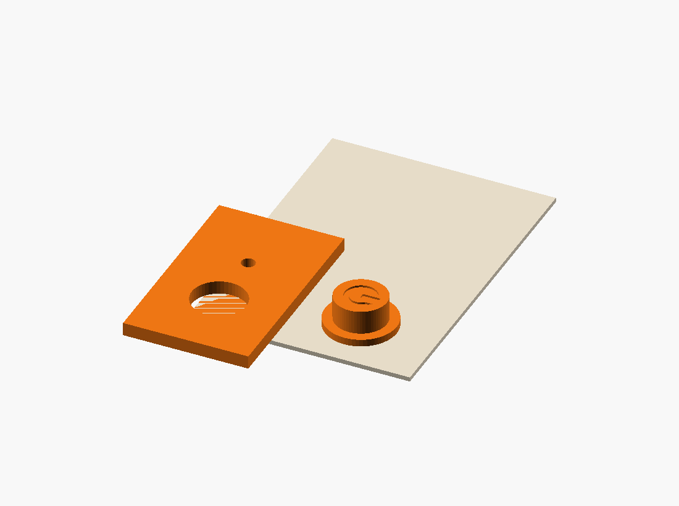
docs/manual_completo/img/v_prueba_boton.png
