Sopa-IA/Control-deck/(commit log)

2026-10-18 docs: investigación de fase 1 y decisiones del prototipo
    Añade el README de Orbit Terminal, las notas de diseño y las reglas
    para dejar fuera del repositorio los secretos (.env).
2026-10-18 hardware: CAD paramétrico OpenSCAD y STL provisionales
    Modelos de la cuña y piezas exportadas, marcadas como no aptas para
    fabricación hasta validarlas con el hardware real.
    [PROVISIONAL_anillo_luz_x2.stl, PROVISIONAL_bandeja_servicio.stl, PROVISIONAL_base_x0_y0.stl, PROVISIONAL_base_x0_y1.stl, PROVISIONAL_base_x1_y0.stl, PROVISIONAL_base_x1_y1.stl, PROVISIONAL_bisel_x0_y0.stl, PROVISIONAL_bisel_x0_y1.stl]
2026-10-18 assets: renders del diseño v0 y capturas de la interfaz
2026-10-18 software: protocolo, orbitd, hp-agent, Arduino e interfaz en simulación
    El hub, el agente del HP y la interfaz Orbit OS corren en simulación.
    No se ha probado en la Pi, el HP, el Arduino ni el monitor reales.
2026-10-18 ci: tests, scripts de desarrollo y workflow de GitHub Actions
    Alinea ruff, pytest, tsc, vitest y el build de Vite con la raíz del
    repositorio.
2026-10-18 cad: v1 con potenciómetros, Arduino Micro y sin KVM
    Cuña pensada para la Bambu Lab A1. Las cotas de mandos, puertos y
    teclas son provisionales: el modelo no está listo para fabricar.
    [PROVISIONAL_anillo_luz_x2.stl, PROVISIONAL_bandeja_servicio.stl, PROVISIONAL_base_x0_y0.stl, PROVISIONAL_base_x0_y1.stl, PROVISIONAL_base_x1_y0.stl, PROVISIONAL_base_x1_y1.stl, PROVISIONAL_bisel_x0_y0.stl, PROVISIONAL_bisel_x0_y1.stl]
2026-10-18 software: asignación por defecto de 2 potenciómetros y 2 botones
    El firmware, el simulador y la interfaz siguen aceptando otros
    recuentos. El prototipo parte de P1–P2 (A0, A1) y B1–B2 (D2, D3).
2026-10-18 Integración HP Slimline 260-a110ns sin carcasa + conmutación automática desde Orbit OS (v2) (#3)
    * docs: HP Slimline 260-a110ns y cambio automático de sistema
    La placa se desmonta y entra en la cuña. El modo A (Sunshine/Moonlight)
    es la base; el modo B por DDC/CI queda sin verificar.
    * cad: placa mini-ITX del HP sobre separadores, mismas medidas exteriores
    La cuña sigue en 456,3 × 300,5 × 153,9 mm. El adaptador de 65 W queda
    fuera. Los STL siguen siendo provisionales.
    * assets: renders de la cuña con la placa del HP Slimline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
    [PROVISIONAL_bandeja_servicio.stl, PROVISIONAL_base_x0_y0.stl, PROVISIONAL_base_x0_y1.stl, PROVISIONAL_base_x1_y0.stl, PROVISIONAL_base_x1_y1.stl, PROVISIONAL_carcasa_x0_y1.stl, PROVISIONAL_soporte_disco.stl, carcasa.scad]
2026-10-18 HP v3: medidas reales, patrón mini-ITX corregido y modo de vídeo por capturadora (#4)
    * docs: medidas reales de la placa y modo de vídeo por capturadora
    Miguel midió 17 × 17 cm y 35 mm de alto. El agujero F pasa al patrón
    mini-ITX. El modo B por DDC/CI queda como poco probable.
    * cad: altura de 35 mm y agujero F; solo cambia la base x0 y1
    El STL tocado es PROVISIONAL_base_x0_y1. La cuña sigue sin estar
    lista para fabricar.
    * assets: renders con la placa medida y la reserva de la capturadora
    * protocolo: el es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
    [PROVISIONAL_base_x0_y1.stl, componentes.scad, params.scad]
2026-10-18 Renders fotorrealistas del prototipo con las piezas reales de Miguel (#5)
    * render: créditos y licencias de los modelos 3D
    La Pi 4 es CC0 y no se guarda en el repo. El resto es geometría
    propia bajo Apache-2.0. Las fotos de Miguel no se suben.
    * render: pipeline de Blender para las vistas del prototipo
    Descarga el modelo CC0 fuera del repo y compone las láminas sin
    fotos personales.
    * assets: renders fotorrealistas del diseño CAD v3
    No son fotos ni un prototipo fabricado. La lámina 06 usa recortes
    del propio render.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
    [partes_render.scad]
2026-10-20 Base con HDD 3,5", plantillas mini-ITX y documento de traspaso (#6)
    * cad: HDD 3,5" Toshiba, separadores abiertos y STL regenerados
    El modelo pasa a usar_hdd_35 con cotas SFF-8301, no con la medición a ojo. Las patas del soporte suben a 14 mm para librar las pletinas, los colisos quedan a 3,18 mm del lateral, las torretas de empalme llevan paso de 3,4 mm y el agujero del inserto de los separadores queda abierto por arriba. Se regeneran los 20 STL. No apto para fabricación.
    * impresion: guía de la base, pared de I/O y plantillas mini-ITX
    Añade la guía de impresión de la base, el recorte de la pared trasera (el scad incluye pie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
    [PROVISIONAL_anillo_luz_x2.stl, PROVISIONAL_bandeja_servicio.stl, PROVISIONAL_base_x0_y0.stl, PROVISIONAL_base_x0_y1.stl, PROVISIONAL_base_x1_y0.stl, PROVISIONAL_base_x1_y1.stl, PROVISIONAL_bisel_x0_y0.stl, PROVISIONAL_bisel_x0_y1.stl]
2026-10-20 Siguientes impresiones: STEP para SolidWorks, plantilla de pivotes y manual de montaje (#7)
    * impresion: STEP de las siguientes piezas y guía en Markdown
    Añade los STEP AP214 numerados en el orden de impresión, los de la base y la vista de la plantilla de pivotes. La guía apunta a los STL que ya están en el repo, sin duplicarlos. El CAD no se regenera.
    * docs: manual de montaje y estado de las siguientes impresiones
    Enlaza el PDF de 21 páginas desde el README y deja en el traspaso el orden de impresión, los STEP de malla y la plantilla de pivotes, todavía sin resultado.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
    [01_PRUEBA_plantilla_pivotes_HP.step, 02_PROVISIONAL_bandeja_servicio.step, 03_PROVISIONAL_carcasa_x0_y1.step, 04_PROVISIONAL_carcasa_x0_y0.step, 05_PROVISIONAL_carcasa_x1_y0.step, 06_PROVISIONAL_carcasa_x1_y1.step, 07_PROVISIONAL_bisel_x0_y0.step, 08_PROVISIONAL_bisel_x0_y1.step]
2026-10-21 Nano de mandos, prácticas y bahía modular a la izquierda de la canaleta (#8)
    * Nano de mandos, ESP8266 y placa de prácticas en la trasera
    El Micro pasa a un Nano sin HID. La bandeja impresa no se regenera.
    El Uno no cabe bien junto al ESP: las prácticas van en un segundo Nano,
    con pines, OLED y un hueco USB. Solo se regeneran el soporte y la carcasa trasera derecha.
    * Bahía modular en las dos torretas de la izquierda de la canaleta
    El riel y tres carros (Nano de prácticas, ESP8266 y proto 30×70) se atornillan a las torretas DC ya impresas. El soporte del Nano de mandos no se modifica.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
    [PROVISIONAL_carcasa_x1_y1.stl, PROVISIONAL_carro_esp.stl, PROVISIONAL_carro_nano.stl, PROVISIONAL_carro_proto30x70.stl, PROVISIONAL_riel_placas.stl, PROVISIONAL_soporte_arduino.stl, carcasa.scad, componentes.scad]
2026-10-21 Bandeja v2: Pi con los USB hacia la trasera y bahía integrada.
    La base y los 4 M3 no se mueven. La Pi queda en la mitad izquierda,
    los puertos bajo una tapa del techo, y los carros retienen las placas
    con los pines hacia abajo. Se retira el riel suelto de la bandeja v1.
    [PROVISIONAL_bandeja_servicio.stl, PROVISIONAL_carcasa_x1_y1.stl, PROVISIONAL_carro_esp.stl, PROVISIONAL_carro_nano.stl, PROVISIONAL_carro_proto30x70.stl, PROVISIONAL_retenedor_nano.stl, PROVISIONAL_riel_placas.stl, PROVISIONAL_tapa_pi.stl]
2026-10-21 Bandeja v2: aire para la Pi y carros con dos M3.
    Rejilla bajo el SoC, salida por la tapa y la rejilla trasera, y cajeado con dos tornillos por puesto para que el carro no gire.
    [PROVISIONAL_bandeja_servicio.stl, PROVISIONAL_carcasa_x1_y1.stl, PROVISIONAL_carro_esp.stl, PROVISIONAL_carro_nano.stl, PROVISIONAL_carro_proto30x70.stl, PROVISIONAL_tapa_pi.stl, carcasa.scad, componentes.scad]
2026-10-22 Guías autorroscantes en la bandeja y en carcasa_x1_y1.
    Miguel no usa insertos. Los cuatro agujeros de los carros y los de los postes y orejetas de la carcasa aún sin imprimir pasan a Ø2,5. La base, las otras tres carcasas, el soporte y los biseles no se tocan.
    [PROVISIONAL_bandeja_servicio.stl, PROVISIONAL_carcasa_x1_y1.stl, carcasa.scad, lib.scad, params.scad, piezas.scad]
2026-10-22 Placa I/O del HP para la ventana ya impresa, con una prueba de huecos.
    Los huecos salen de la foto del 2026-10-22 y quedan [PENDIENTE]. carcasa_x0_y1 no se regenera.
    [PROVISIONAL_placa_io_hp.stl, PRUEBA_placa_io_hp.stl, params.scad, partes.scad, piezas.scad]
2026-10-22 Bandeja con huecos fijos: Pi, Nanos, ESP y step-down, sin carros.
    Cada placa va en un bolsillo de la plancha. Los carros y el retenedor quedan obsoletos. El contorno, los 4 M3 a la base, la Pi y la rejilla no se mueven.
    [PROVISIONAL_bandeja_servicio.stl, componentes.scad, ensamblaje.scad, params.scad, partes.scad, piezas.scad]
2026-10-22 Manual de montaje con renders del CAD y PDF de los pasos 0 a 11.
    [escena.scad]
2026-10-22 Manual de montaje por subpasos, con tornillo concreto y lista de compra.
    [escena.scad]
2026-10-22 Añade el capuchón, el soporte y la prueba del botón de encendido, con sus subpasos.
    [PROVISIONAL_boton_encendido.stl, PROVISIONAL_soporte_boton.stl, PRUEBA_boton.stl, escena.scad, params.scad, partes.scad, piezas.scad]
2026-10-22 Deja 13 mm libres bajo las filas de pines de los Nano y del ESP, y lo enseña en el corte del manual.
    [PROVISIONAL_bandeja_servicio.stl, escena.scad, params.scad, piezas.scad]
2026-10-22 Pasa la tornillería de Orbit a los tres kits y enlaza el inventario del taller desde el manual.
    [PROVISIONAL_bandeja_servicio.stl, PROVISIONAL_grapa_esquina.stl, PROVISIONAL_pomo_x2.stl, escena.scad, params.scad, partes.scad, piezas.scad]
2026-10-22 Deja la vista integrada de Moonlight como modo por defecto y hace que la Pi arranque directo a Orbit OS.
2026-10-22 Añade Ardu Lab para programar el Nano de prácticas desde Orbit OS y bloquea el de mandos.
2026-10-23 Añade los cuatro adaptadores de la carcasa ya impresa.
    Los cortes a cuchillo se tapan con placas pequeñas. No se exportan STL nuevos de carcasa.
    [PROVISIONAL_marco_io_frontal.stl, PROVISIONAL_panel_pines.stl, PROVISIONAL_placa_io_hp.stl, PROVISIONAL_placa_puertos_pi.stl, PRUEBA_placa_io_hp.stl, carcasa.scad, params.scad, partes.scad]
2026-10-23 Los adaptadores entran en los huecos ya impresos, sin cortar la carcasa.
    El marco frontal, la tapa de los agujeros viejos y la careta de pines
    se quedan en las ventanas que hay. Los dos STL FUTURO_carcasa quedan
    exportados y marcados como no imprimir ahora.
    [FUTURO_carcasa_x0_y1_sin_adaptadores.stl, FUTURO_carcasa_x1_y1_sin_adaptadores.stl, PROVISIONAL_marco_io_frontal.stl, PROVISIONAL_panel_pines.stl, PROVISIONAL_placa_puertos_pi.stl, carcasa.scad, params.scad, partes.scad]
2026-10-23 Abre ventanas en los cantos largos de la bandeja v3.
    Los pines macho quedaban encerrados y un Dupont recto no entra en los 13 mm. La v3 no sube las placas: el ESP solo tiene 4,8 mm hasta la tina. Hace falta Dupont hembra a 90°. La bandeja ya impresa queda obsoleta y no se corta.
    [OBSOLETA_bandeja_huecos_v2_ya_impresa.stl, PROVISIONAL_bandeja_servicio.stl, params.scad, piezas.scad]
2026-10-23 Mete la tapa de la Pi dentro del lomo plano, con tetón en el hueco.
    La impresa sobresalía por el canto delantero. La placa nueva queda en y 248,5–295,29, el tetón entra en el hueco de 72 × 42 con 0,3 mm por lado y los dos Ø3,4 no se mueven. La carcasa no se regenera.
    [PROVISIONAL_tapa_pi.stl, carcasa.scad, params.scad]
2026-10-23 Deja el instalador de la Pi repetible y apaga de verdad tras confirmar.
    sudoers solo admite systemctl poweroff y reboot para el usuario de orbitd. El simulador no llama a systemctl. En Debian Bookworm arm64 el script termina dos veces sin errores y la segunda no cambia los tokens.
    [__main__.py, hub.py, power.py]
2026-10-23 Añade el manual completo de montaje y software.
    Un PDF de 91 páginas, un paso y una figura, a partir del CAD. Los manuales anteriores quedan sustituidos.
    [completo.scad]
2026-10-23 Quita el error de nmcli, anota los Nano después y apaga la traducción del kiosco.
    El listado de nmcli no acepta connection.interface-name; ahora se pregunta
    perfil a perfil. Si no hay /dev/serial/by-path el instalador sigue, y
    detectar-nanos.sh escribe arduino-puertos.json cuando las placas estén
    enchufadas. Chromium del kiosco lleva un solo --disable-features con
    Translate, --lang=es y la política TranslateEnabled=false. swaybg pinta
    negro al entrar en la sesión, si el paquete está.
    [completo_pdf.py]
2026-10-23 Abre Orbit OS en una sesión labwc propia, sin el escritorio.
    labwc-pi arranca con -m y mezcla el autostart del escritorio, así que
    la barra y el fondo se veían antes del kiosco. LightDM entra ahora en
    la sesión orbit (labwc -C /etc/orbit/labwc): fondo negro y el kiosco.
    Ctrl+Alt+T sigue abriendo una terminal. sudo orbit-escritorio devuelve
    el escritorio de Raspberry Pi.
2026-10-23 Anima el planeta de Inicio con poco coste en la Pi.
2026-10-23 Desbloquea el Bluetooth en cada arranque y documenta el teclado.
2026-10-23 Conecta solo los teclados Bluetooth de confianza al arrancar.
2026-10-23 El material de impresión es PLA+ negro mate y la imagen del HP llega por Moonlight.
    [params.scad]
2026-10-24 Detecta el emparejamiento de Moonlight por srvcert, no por pairState.
2026-10-24 Instala hp-agent en el HP con una línea, sin mostrar el token.
2026-10-24 El instalador de la Pi ya no toca el perfil Wi-Fi.
2026-10-24 hp-agent envía la bajada y la subida de red del HP, como la Pi.
2026-10-24 El HP envía red, temperatura y volumen, y los potenciómetros al aire dejan de mandar acciones.
2026-10-24 El HP envía la red en kb/s y la temperatura de la CPU con LibreHardwareMonitor.
2026-10-24 Orbit OS pasa a 1.0.0: cada control hace algo real o queda apagado si falta el hardware.
2026-10-24 Documenta el estado real de la Pi y del HP el 2026-10-24 para retomar sin el chat.
2026-10-30 docs: quitar modelo del HP, IPs de la red interna y rama de trabajo del README y la guía del HP (#10)
